Cardansan/Cruz-De-Seguridad/fotos/IMG_20190821_163145_097.jpg

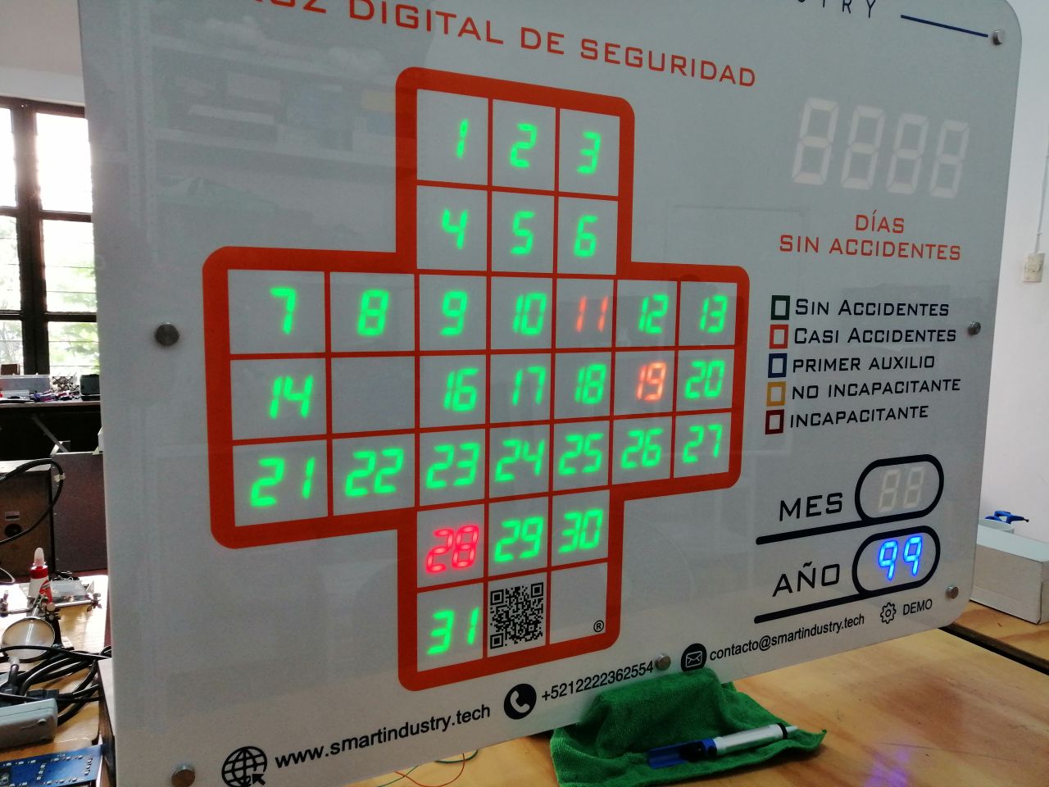
fotos/IMG_20190821_163145_097.jpg
