Cardansan/Cruz-De-Seguridad/fotos/IMG_20190821_163332_399.jpg

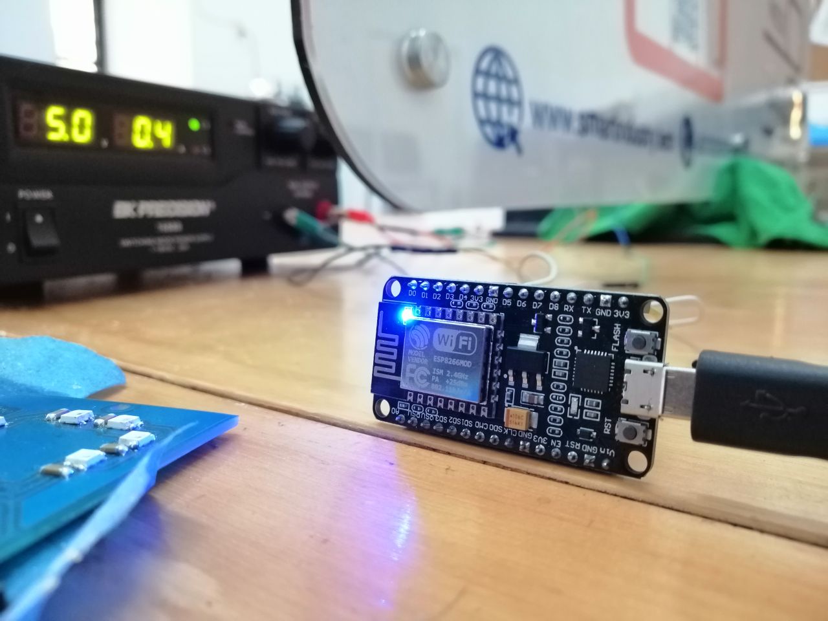
fotos/IMG_20190821_163332_399.jpg
