Cardansan/Cruz-De-Seguridad/README.md

# Cruz-De-Seguridad
Display Industria 4.0
