Cardansan/Cruz-De-Seguridad/diseños/Cortes 4 Dígitos Grande/Imágenes/4 Dígitos CABLE.JPG

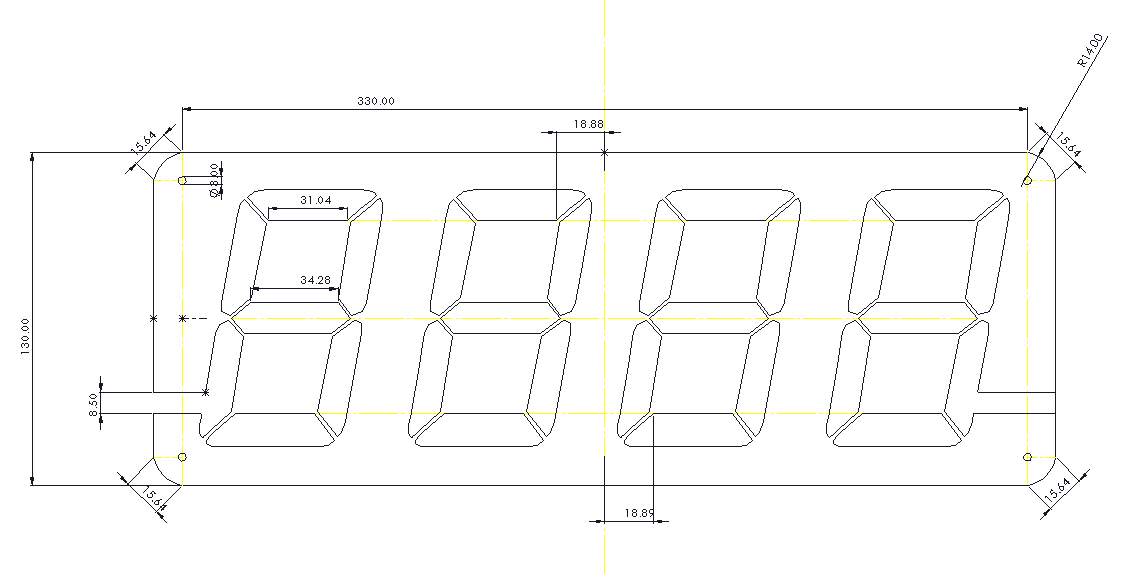
diseños/Cortes 4 Dígitos Grande/Imágenes/4 Dígitos CABLE.JPG
