Cardansan/Cruz-De-Seguridad/diseños/Cortes 4 Dígitos Grande/Imágenes/4 Dígitos TOP.JPG

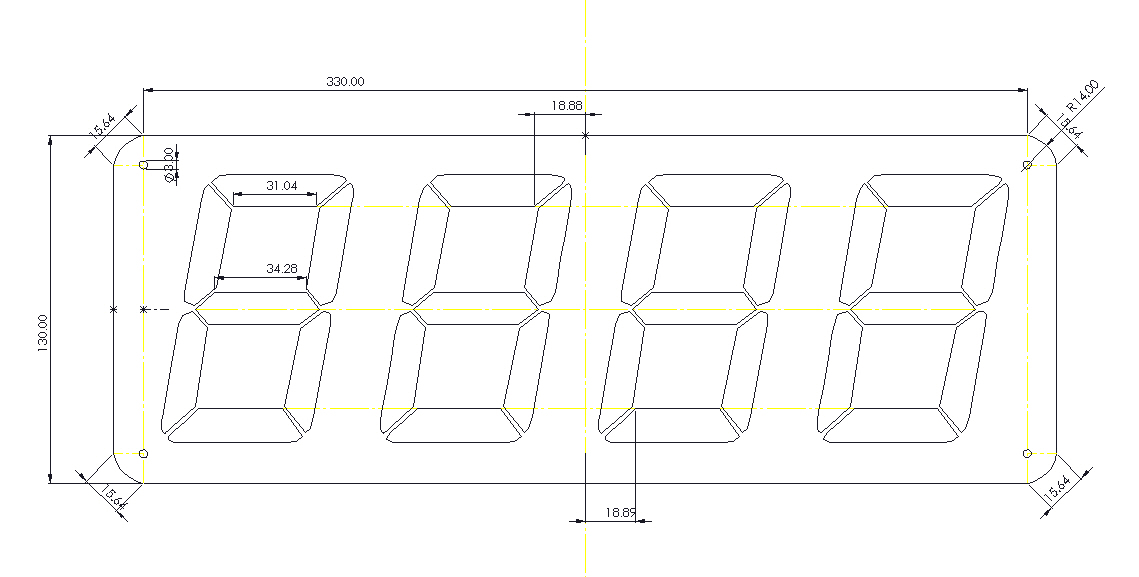
diseños/Cortes 4 Dígitos Grande/Imágenes/4 Dígitos TOP.JPG
