Cardansan/Cruz-De-Seguridad/diseños/PCB/Escudo_cruz/Conexion_SDCS.jpg

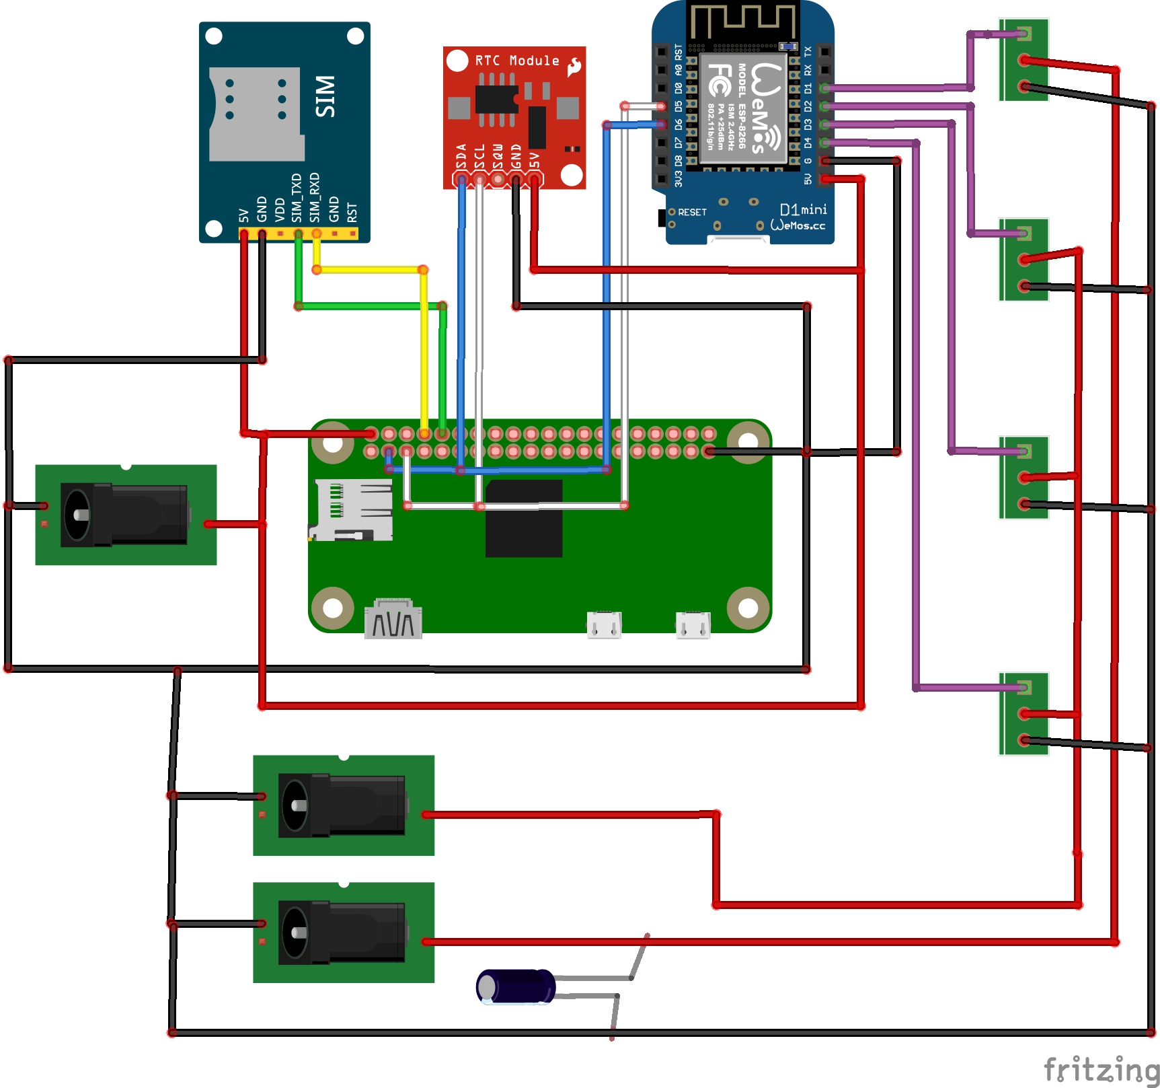
diseños/PCB/Escudo_cruz/Conexion_SDCS.jpg
