Cardansan/Cruz-De-Seguridad/fotos/IMG_20190808_111240.jpg

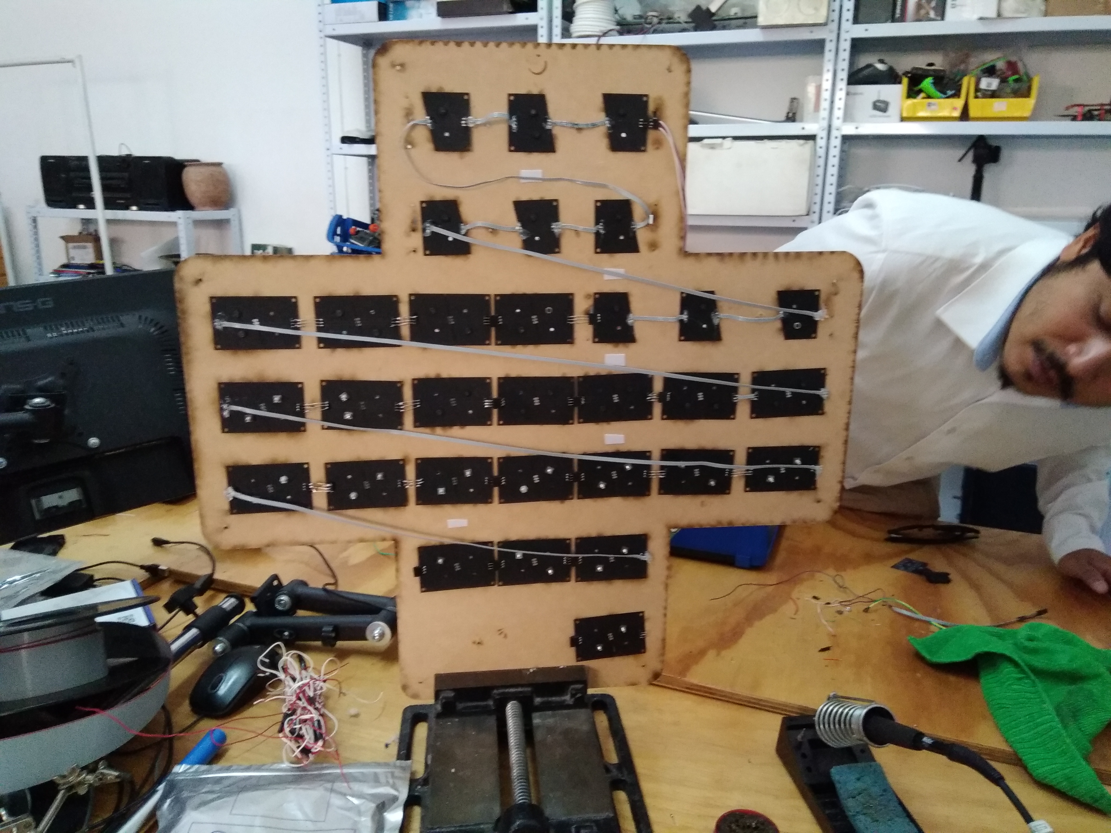
fotos/IMG_20190808_111240.jpg
