Cardansan/Cruz-De-Seguridad/fotos/IMG_20190814_174807.jpg

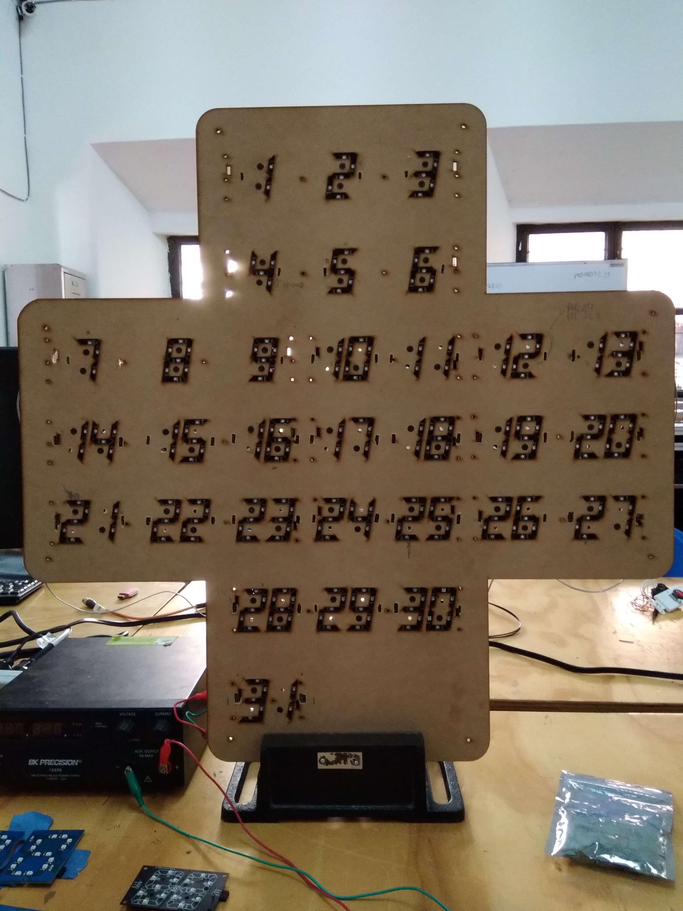
fotos/IMG_20190814_174807.jpg
