Cardansan/Cruz-De-Seguridad/fotos/IMG_20190814_174841.jpg

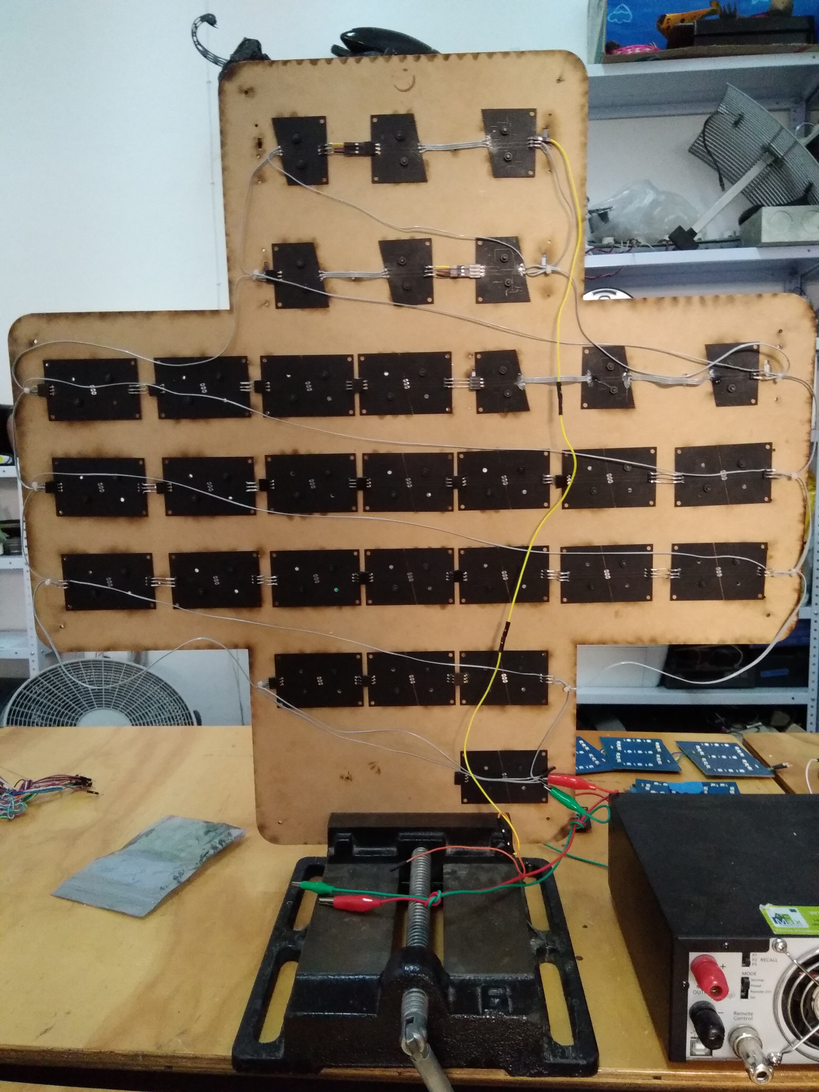
fotos/IMG_20190814_174841.jpg
