Cardansan/Cruz-De-Seguridad/fotos/IMG_20190816_145346.jpg

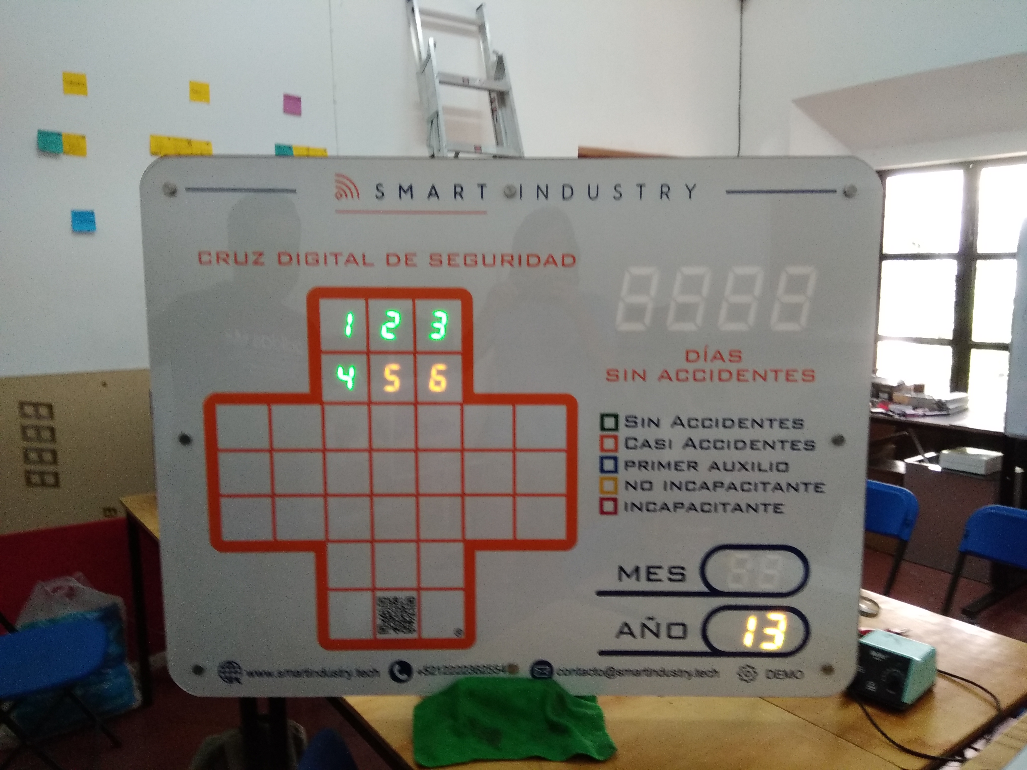
fotos/IMG_20190816_145346.jpg
