Cardansan/Cruz-De-Seguridad/fotos/IMG_20190816_145348.jpg

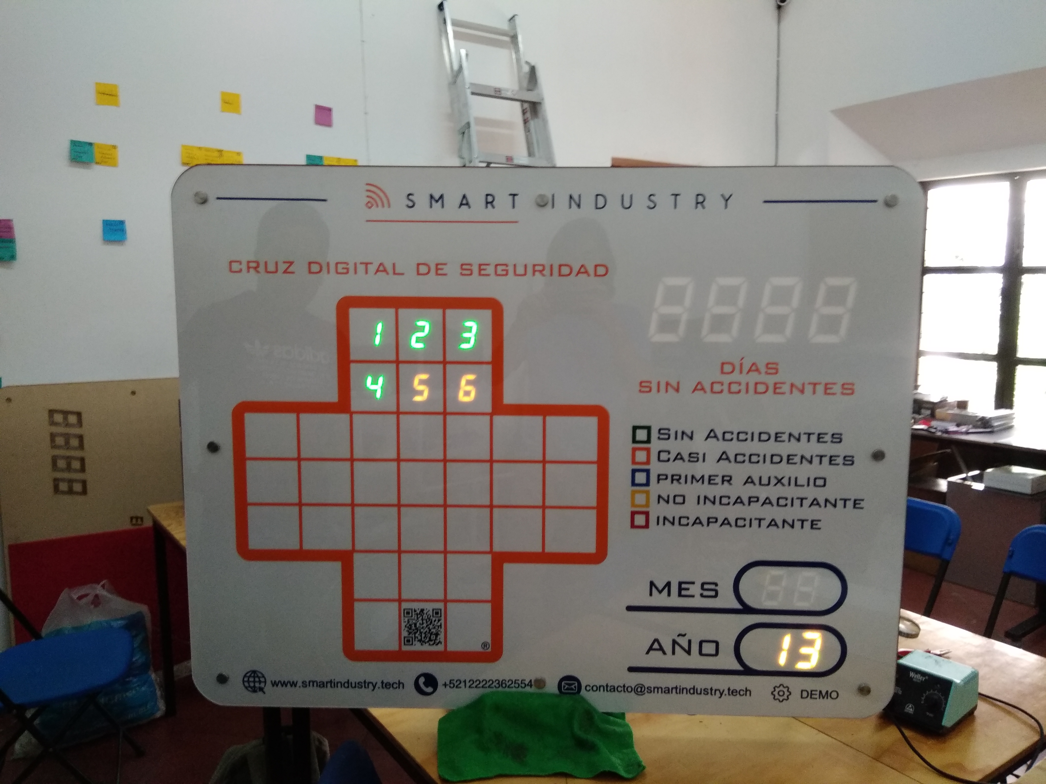
fotos/IMG_20190816_145348.jpg
