Cardansan/Cruz-De-Seguridad/fotos/IMG_20190816_145359.jpg

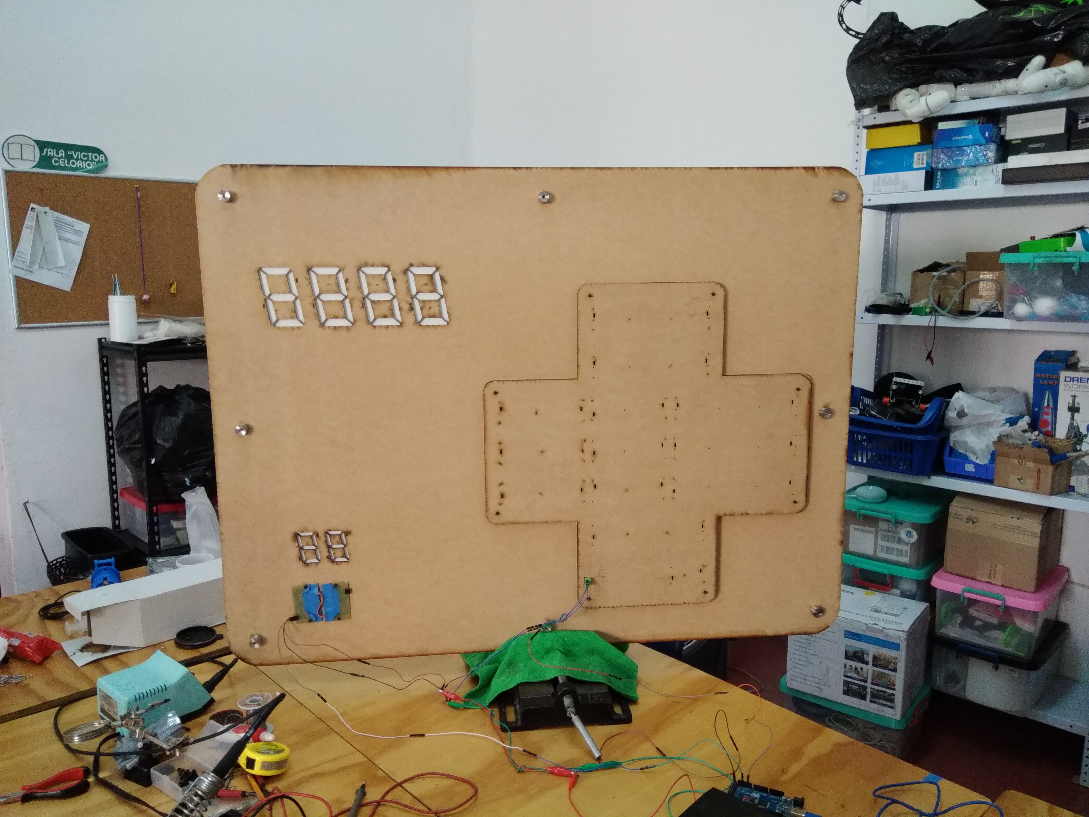
fotos/IMG_20190816_145359.jpg
