Cardansan/Cruz-De-Seguridad/fotos/IMG_20190821_163135_744.jpg

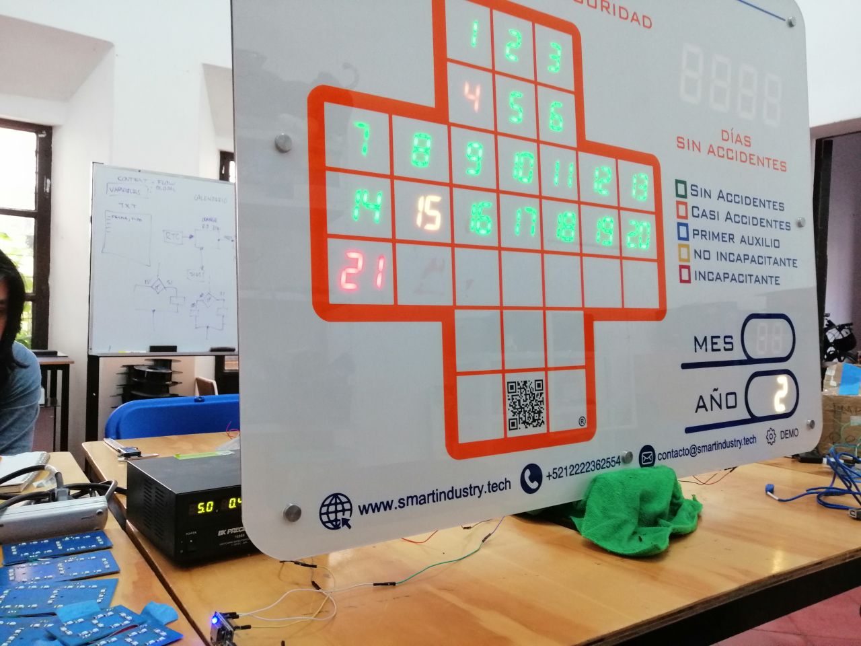
fotos/IMG_20190821_163135_744.jpg
