Cardansan/Cruz-De-Seguridad/fotos/IMG_20190821_163142_463.jpg

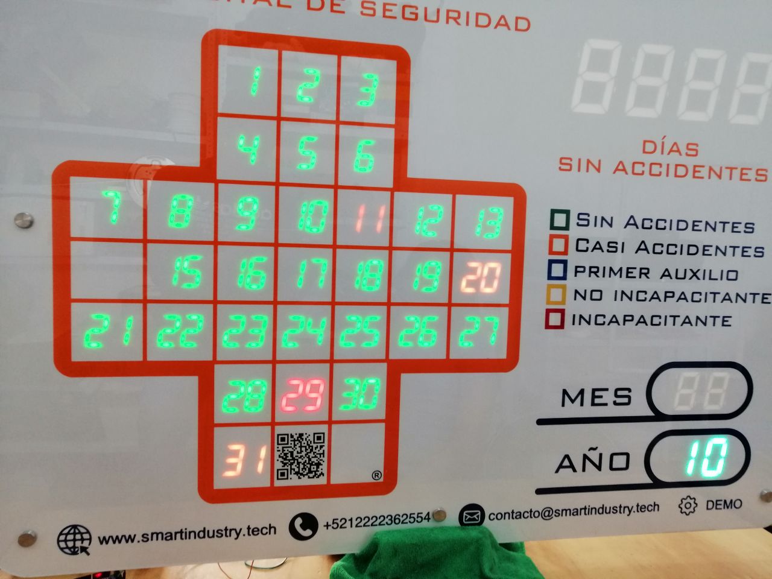
fotos/IMG_20190821_163142_463.jpg
