Cardansan/Cruz-De-Seguridad/diseños/Cortes 4 Dígitos Grande/Ensamble mdf unitario.SLDPRT

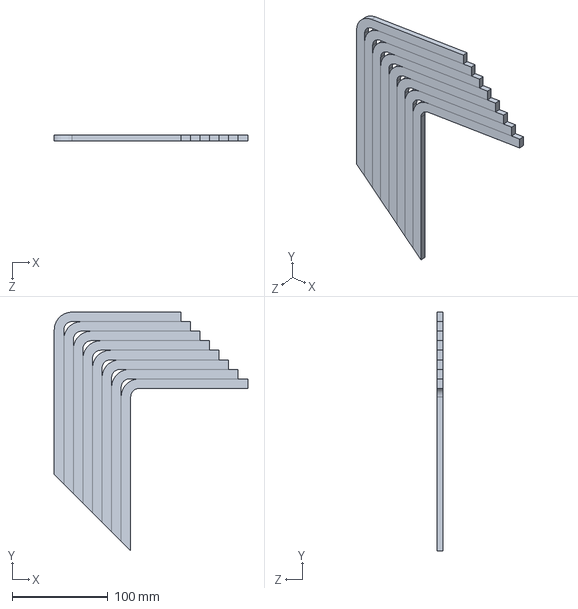
[picture p15: CAD file, 2019-05-18]
diseños/Cortes 4 Dígitos Grande/Ensamble mdf unitario.SLDPRT
202.5 x 250.0 x 6.00 mm
