Cardansan/Cruz-De-Seguridad/diseños/Ensamble/Ensamble cruz de seguridad.SLDASM

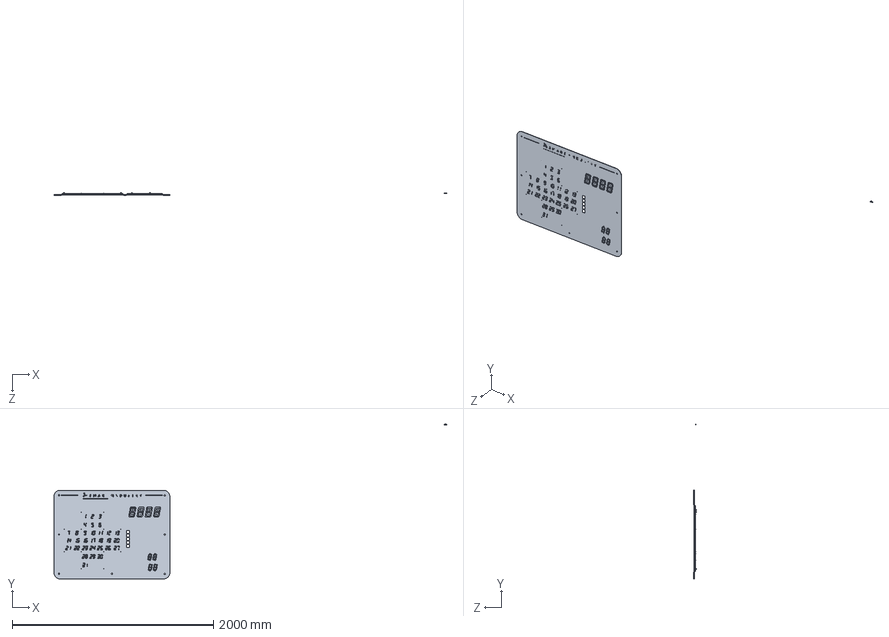
[picture p16: CAD file, 2019-06-06]
diseños/Ensamble/Ensamble cruz de seguridad.SLDASM
3904.5 x 1537.3 x 21.0 mm
Cruz Digital Original
Cruz capa 1
Cruz capa 2
Cruz capa 3
Pin_1 x 264
Pin_2 x 264
Pin_3 x 264
Pin_4 x 264
Pin_1_2 x 263
Pin_2_2 x 263
Layer_1
METRIC FLAT HEAD SLOTTED MACHINE SCREW M3x.5x20 x 16
Grupo 2 capa 1
Grupo 2 capa 3
Grupo 2 capa 2
Grupo 3 capa 1
Grupo 3 capa 2
Grupo 3 capa 3
