Cardansan/Cruz-De-Seguridad/(list of files, cad)

Other CAD files:
diseños/Ensamble/PCB MK XV/Open CASCADE STEP translator 6.8 1.202.sldasm
diseños/Ensamble/PCB MK XV/Open CASCADE STEP translator 6.8 1.4.1-160.sldasm
diseños/Ensamble/PCB MK XV/Open CASCADE STEP translator 6.8 1.508.sldasm
diseños/Ensamble/PCB MK XV/Open CASCADE STEP translator 6.8 1.4.1-197.sldasm
diseños/Ensamble/PCB MK XV/Open CASCADE STEP translator 6.8 1.2.1-217.sldasm
diseños/Ensamble/PCB MK XV/Open CASCADE STEP translator 6.8 1.2.1-164.sldasm
diseños/Ensamble/PCB MK XV/Open CASCADE STEP translator 6.8 1.140.sldasm
diseños/Ensamble/PCB MK XV/Open CASCADE STEP translator 6.8 1.4.1-29.sldasm
diseños/Ensamble/PCB MK XV/Open CASCADE STEP translator 6.8 1.4.1-256.sldasm
diseños/Ensamble/PCB MK XV/Open CASCADE STEP translator 6.8 1.2.1-130.sldasm
diseños/Ensamble/PCB MK XV/Open CASCADE STEP translator 6.8 1.2.1-125.sldasm
diseños/Ensamble/PCB MK XV/Open CASCADE STEP translator 6.8 1.194.sldasm
diseños/Ensamble/PCB MK XV/Open CASCADE STEP translator 6.8 1.539.sldasm
diseños/Ensamble/PCB MK XV/Open CASCADE STEP translator 6.8 1.466.1.sldasm
diseños/Ensamble/PCB MK XV/Open CASCADE STEP translator 6.8 1.2.1-28.sldasm
diseños/Ensamble/PCB MK XV/Open CASCADE STEP translator 6.8 1.4.1-118.sldasm
diseños/Ensamble/PCB MK XV/Open CASCADE STEP translator 6.8 1.26.sldasm
diseños/Ensamble/PCB MK XV/Open CASCADE STEP translator 6.8 1.4.1-26.sldasm
diseños/Ensamble/PCB MK XV/Open CASCADE STEP translator 6.8 1.410.sldasm
diseños/Ensamble/PCB MK XV/Open CASCADE STEP translator 6.8 1.227.sldasm
diseños/Ensamble/PCB MK XV/Open CASCADE STEP translator 6.8 1.95.1.sldasm
diseños/Ensamble/PCB MK XV/Open CASCADE STEP translator 6.8 1.2.1-65.sldasm
diseños/Ensamble/PCB MK XV/Open CASCADE STEP translator 6.8 1.47.sldasm
diseños/Ensamble/PCB MK XV/Open CASCADE STEP translator 6.8 1.2.1-234.sldasm
diseños/Ensamble/PCB MK XV/Open CASCADE STEP translator 6.8 1.2.1-192.sldasm
diseños/Ensamble/PCB MK XV/Open CASCADE STEP translator 6.8 1.2.1-22.sldasm
diseños/Ensamble/PCB MK XV/Open CASCADE STEP translator 6.8 1.311.sldasm
diseños/Ensamble/PCB MK XV/Open CASCADE STEP translator 6.8 1.2.1-150.sldasm
diseños/Ensamble/PCB MK XV/Open CASCADE STEP translator 6.8 1.97.sldasm
diseños/Ensamble/PCB MK XV/Open CASCADE STEP translator 6.8 1.136.sldasm
diseños/Ensamble/PCB MK XV/Open CASCADE STEP translator 6.8 1.89.sldasm
diseños/Ensamble/PCB MK XV/Open CASCADE STEP translator 6.8 1.173.sldasm
diseños/Ensamble/PCB MK XV/Open CASCADE STEP translator 6.8 1.278.sldasm
diseños/Ensamble/PCB MK XV/Open CASCADE STEP translator 6.8 1.4.1-255.sldasm
diseños/Ensamble/PCB MK XV/Open CASCADE STEP translator 6.8 1.555.1.sldasm
diseños/Ensamble/PCB MK XV/Open CASCADE STEP translator 6.8 1.2.1-41.sldasm
diseños/Ensamble/PCB MK XV/Open CASCADE STEP translator 6.8 1.4.1-210.sldasm
diseños/Ensamble/PCB MK XV/Open CASCADE STEP translator 6.8 1.176.sldasm
diseños/Ensamble/PCB MK XV/Open CASCADE STEP translator 6.8 1.4.1-117.sldasm
diseños/Ensamble/PCB MK XV/Open CASCADE STEP translator 6.8 1.416.sldasm
diseños/Ensamble/PCB MK XV/Open CASCADE STEP translator 6.8 1.4.1-70.sldasm
diseños/Ensamble/PCB MK XV/Open CASCADE STEP translator 6.8 1.556.sldasm
diseños/Ensamble/PCB MK XV/Open CASCADE STEP translator 6.8 1.4.1-65.sldasm
diseños/Ensamble/PCB MK XV/Open CASCADE STEP translator 6.8 1.4.1-109.sldasm
diseños/Ensamble/PCB MK XV/Open CASCADE STEP translator 6.8 1.4.1-151.sldasm
diseños/Ensamble/PCB MK XV/Open CASCADE STEP translator 6.8 1.413.sldasm
diseños/Ensamble/PCB MK XV/Open CASCADE STEP translator 6.8 1.4.1-124.sldasm
diseños/Ensamble/PCB MK XV/Open CASCADE STEP translator 6.8 1.4.1-177.sldasm
diseños/Ensamble/PCB MK XV/Open CASCADE STEP translator 6.8 1.139.1.sldasm
diseños/Ensamble/PCB MK XV/Open CASCADE STEP translator 6.8 1.235.sldasm
diseños/Ensamble/PCB MK XV/Open CASCADE STEP translator 6.8 1.4.1-139.sldasm
diseños/Ensamble/PCB MK XV/Open CASCADE STEP translator 6.8 1.121.sldasm
diseños/Ensamble/PCB MK XV/Open CASCADE STEP translator 6.8 1.30.sldasm
diseños/Ensamble/PCB MK XV/Open CASCADE STEP translator 6.8 1.472.sldasm
diseños/Ensamble/PCB MK XV/Open CASCADE STEP translator 6.8 1.455.sldasm
diseños/Ensamble/PCB MK XV/Open CASCADE STEP translator 6.8 1.4.1-83.sldasm
diseños/Ensamble/PCB MK XV/Open CASCADE STEP translator 6.8 1.4.1-120.sldasm
diseños/Ensamble/PCB MK XV/Open CASCADE STEP translator 6.8 1.4.1-119.sldasm
diseños/Ensamble/PCB MK XV/Open CASCADE STEP translator 6.8 1.498.sldasm
diseños/Ensamble/PCB MK XV/Open CASCADE STEP translator 6.8 1.339.sldasm
diseños/Ensamble/PCB MK XV/Open CASCADE STEP translator 6.8 1.4.1-77.sldasm
diseños/Ensamble/PCB MK XV/Open CASCADE STEP translator 6.8 1.555.sldasm
diseños/Ensamble/PCB MK XV/Open CASCADE STEP translator 6.8 1.2.1-120.sldasm
diseños/Ensamble/PCB MK XV/Open CASCADE STEP translator 6.8 1.4.1-66.sldasm
diseños/Ensamble/PCB MK XV/Open CASCADE STEP translator 6.8 1.130.sldasm
diseños/Ensamble/PCB MK XV/Open CASCADE STEP translator 6.8 1.2.1-95.sldasm
diseños/Ensamble/PCB MK XV/Open CASCADE STEP translator 6.8 1.4.1-108.sldasm
diseños/Ensamble/PCB MK XV/Open CASCADE STEP translator 6.8 1.118.sldasm
diseños/Ensamble/PCB MK XV/Open CASCADE STEP translator 6.8 1.4.1-183.sldasm
diseños/Ensamble/PCB MK XV/Open CASCADE STEP translator 6.8 1.507.1.sldasm
diseños/Ensamble/PCB MK XV/Open CASCADE STEP translator 6.8 1.4.1-57.sldasm
diseños/Ensamble/PCB MK XV/Open CASCADE STEP translator 6.8 1.2.1-160.sldasm
diseños/Ensamble/PCB MK XV/Open CASCADE STEP translator 6.8 1.383.sldasm
diseños/Ensamble/PCB MK XV/Open CASCADE STEP translator 6.8 1.533.sldasm
diseños/Ensamble/PCB MK XV/Open CASCADE STEP translator 6.8 1.556.1.sldasm
diseños/Ensamble/PCB MK XV/Open CASCADE STEP translator 6.8 1.221.sldasm
diseños/Ensamble/PCB MK XV/Open CASCADE STEP translator 6.8 1.4.1-149.sldasm
diseños/Ensamble/PCB MK XV/Open CASCADE STEP translator 6.8 1.59.sldasm
diseños/Ensamble/PCB MK XV/Open CASCADE STEP translator 6.8 1.549.sldasm
diseños/Ensamble/PCB MK XV/Open CASCADE STEP translator 6.8 1.4.1-194.sldasm
diseños/Ensamble/PCB MK XV/Open CASCADE STEP translator 6.8 1.307.sldasm
diseños/Ensamble/PCB MK XV/Open CASCADE STEP translator 6.8 1.2.1-238.sldasm
diseños/Ensamble/PCB MK XV/Open CASCADE STEP translator 6.8 1.2.1-107.sldasm
diseños/Ensamble/PCB MK XV/Open CASCADE STEP translator 6.8 1.2.1-155.sldasm
diseños/Ensamble/PCB MK XV/Open CASCADE STEP translator 6.8 1.49.sldasm
diseños/Ensamble/PCB MK XV/Open CASCADE STEP translator 6.8 1.448.sldasm
diseños/Ensamble/PCB MK XV/Open CASCADE STEP translator 6.8 1.387.sldasm
diseños/Ensamble/PCB MK XV/Open CASCADE STEP translator 6.8 1.95.sldasm
diseños/Ensamble/PCB MK XV/Open CASCADE STEP translator 6.8 1.15.sldasm
diseños/Ensamble/PCB MK XV/Open CASCADE STEP translator 6.8 1.230.sldasm
diseños/Ensamble/PCB MK XV/Open CASCADE STEP translator 6.8 1.302.sldasm
diseños/Ensamble/PCB MK XV/Open CASCADE STEP translator 6.8 1.4.1-258.sldasm
diseños/Ensamble/PCB MK XV/Open CASCADE STEP translator 6.8 1.2.1-146.sldasm
diseños/Ensamble/PCB MK XV/Open CASCADE STEP translator 6.8 1.2.1-94.sldasm
diseños/Ensamble/PCB MK XV/Open CASCADE STEP translator 6.8 1.275.sldasm
diseños/Ensamble/PCB MK XV/Open CASCADE STEP translator 6.8 1.210.sldasm
diseños/Ensamble/PCB MK XV/Open CASCADE STEP translator 6.8 1.2.1-31.sldasm
diseños/Ensamble/PCB MK XV/Open CASCADE STEP translator 6.8 1.512.sldasm
diseños/Ensamble/PCB MK XV/Open CASCADE STEP translator 6.8 1.27.sldasm
diseños/Ensamble/PCB MK XV/Open CASCADE STEP translator 6.8 1.4.1-226.sldasm
diseños/Ensamble/PCB MK XV/Open CASCADE STEP translator 6.8 1.4.1-158.sldasm
diseños/Ensamble/PCB MK XV/Open CASCADE STEP translator 6.8 1.4.1-89.sldasm
diseños/Ensamble/PCB MK XV/Open CASCADE STEP translator 6.8 1.319.sldasm
diseños/Ensamble/PCB MK XV/Open CASCADE STEP translator 6.8 1.120.sldasm
diseños/Ensamble/PCB MK XV/Open CASCADE STEP translator 6.8 1.2.1-194.sldasm
diseños/Ensamble/PCB MK XV/Open CASCADE STEP translator 6.8 1.4.1-138.sldasm
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
