Cardansan/Cruz-De-Seguridad/diseños/Ensamble/Diagrama_conexiones.jpg

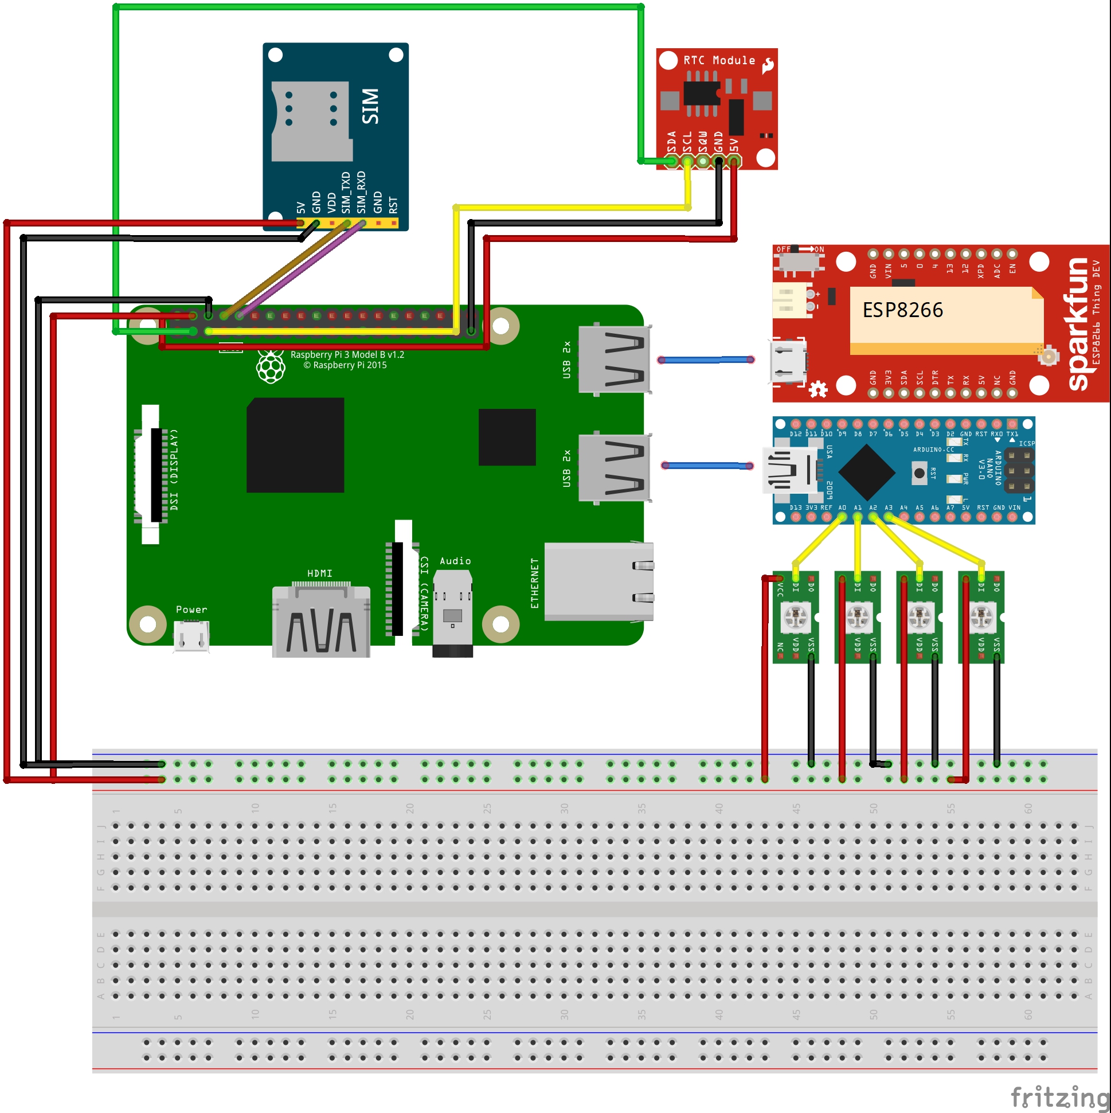
diseños/Ensamble/Diagrama_conexiones.jpg
