Cardansan/Cruz-De-Seguridad/diseños/Ensamble/ESP8266.jpg

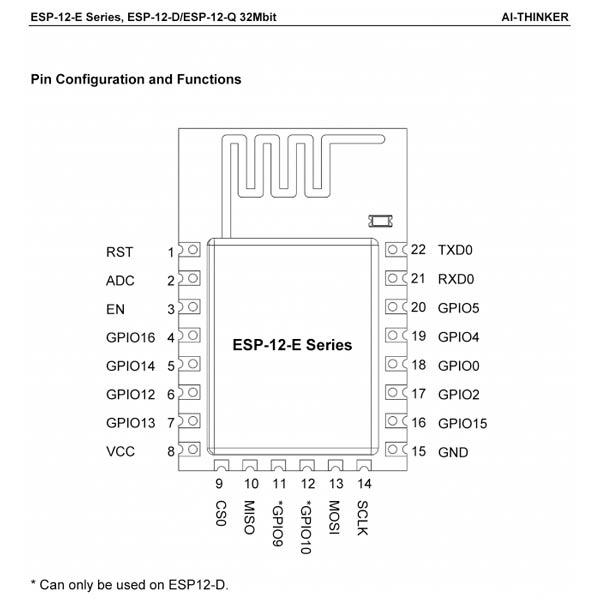
diseños/Ensamble/ESP8266.jpg
