Cardansan/Cruz-De-Seguridad/(list of files, drawings)

Other design files:
diseños/Ensamble/PCB MK XV/pcb segmentos digitos correctos.pdsprj
diseños/Ensamble/PCB MK XV/pcb segmentos digitos MK I.pdsprj
diseños/Ensamble/PCB MK XV/pcb segmentos_digitos.pdsprj
diseños/PCB/1-3.pdsprj
diseños/PCB/4-6.pdsprj
diseños/PCB/7-9.pdsprj
diseños/PCB/10-11.pdsprj
diseños/PCB/12-13.pdsprj
diseños/PCB/14-16.pdsprj
diseños/PCB/17-18.pdsprj
diseños/PCB/19-20.pdsprj
diseños/PCB/21-23.pdsprj
diseños/PCB/24-25.pdsprj
diseños/PCB/26-27.pdsprj
diseños/PCB/28-30.pdsprj
diseños/PCB/31.pdsprj
