Cardansan/Cruz-De-Seguridad/diseños/PCB/P2345.brd

## EAGLE design diseños/PCB/P2345.brd (2019-10-04)

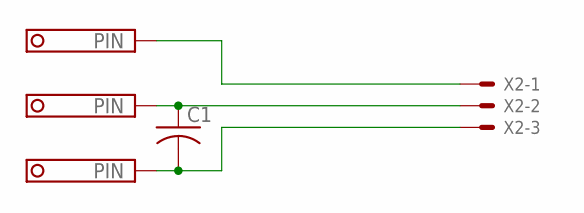
[picture p19: schematic P2345.sch]

Parts:
C1: C-US050-024X044; C050-024X044
X1: TERMINAL-BLOCK-3.5MM-3-PIN-ROUND-PAD; TERMINAL-BLOCK-3-PIN-3.5MM-ROUND-PAD
X2: JST-XH-03-PIN-ROUND-PAD; JST-XH-03-PACKAGE-ROUND-PAD

Connections:
unnamed: X1.1, X2.1
unnamed: C1.1, X1.2, X2.2
unnamed: C1.2, X1.3, X2.3

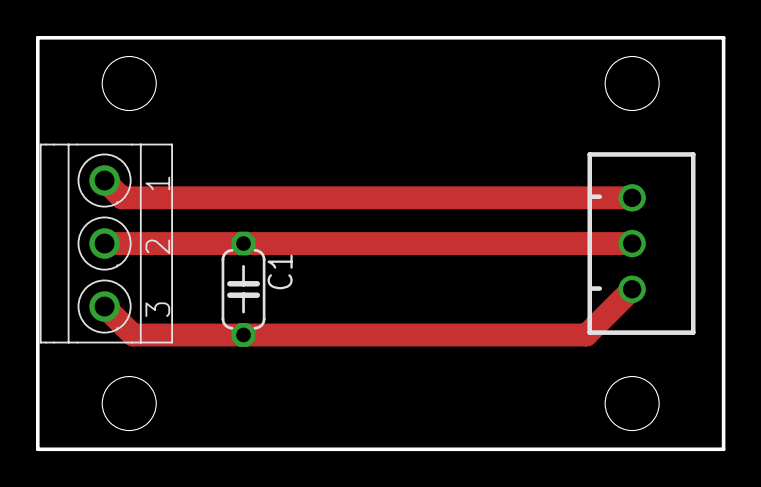
[picture p20: board P2345.brd from above]

Board: 2 copper layers, 38.1 x 22.9 mm, 3 parts (0 on the bottom side), 3 nets.
