Cardansan/Cruz-De-Seguridad/diseños/PCB/P1.brd

## EAGLE design diseños/PCB/P1.brd (2019-10-04)

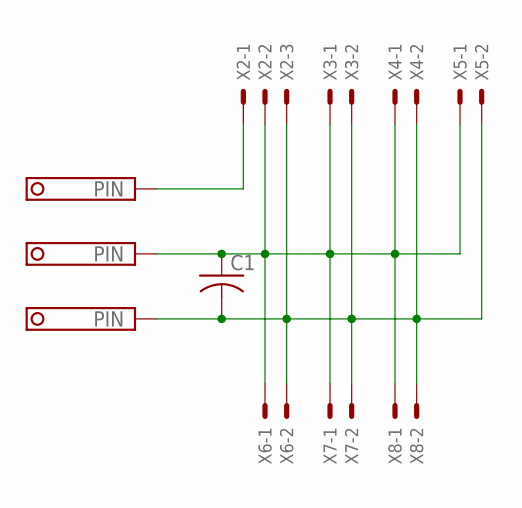
[picture p21: schematic P1.sch]

Parts:
C1: C-US050-024X044; C050-024X044
X1: TERMINAL-BLOCK-3.5MM-3-PIN-ROUND-PAD; TERMINAL-BLOCK-3-PIN-3.5MM-ROUND-PAD
X2: JST-XH-03-PIN-ROUND-PAD; JST-XH-03-PACKAGE-ROUND-PAD
X3, X4, X5, X6, X7, X8: JST-XH-02-PIN-ROUND-PAD; JST-XH-02-PACKAGE-ROUND-PAD

Connections:
unnamed: X1.1, X2.1
unnamed: C1.2, X1.3, X2.3, X3.2, X4.2, X5.2, X6.2, X7.2, X8.2
unnamed: C1.1, X1.2, X2.2, X3.1, X4.1, X5.1, X6.1, X7.1, X8.1

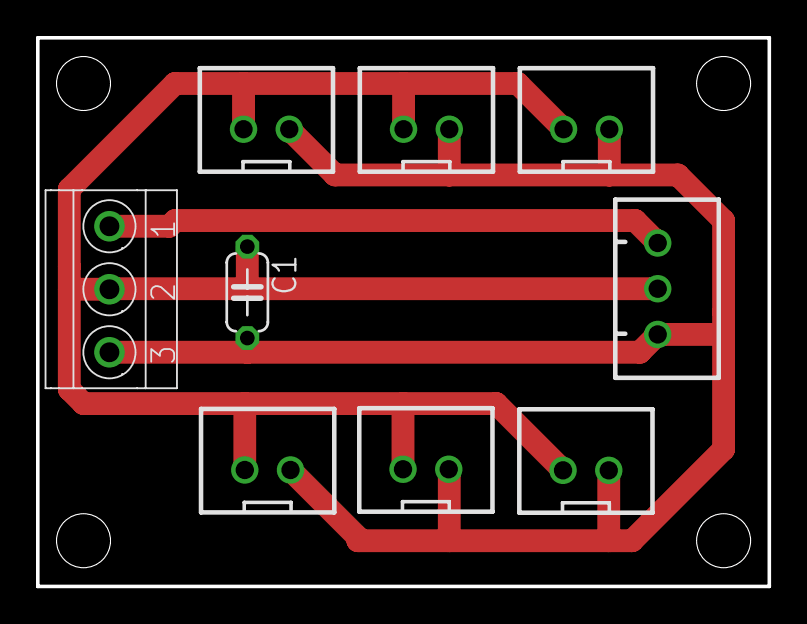
[picture p22: board P1.brd from above]

Board: 2 copper layers, 40.6 x 30.5 mm, 9 parts (0 on the bottom side), 3 nets.
