Cardansan/Cruz-De-Seguridad/diseños/PCB/Escudo_cruz/Escudo_cruz.brd

## EAGLE design diseños/PCB/Escudo_cruz/Escudo_cruz.brd (2019-09-11)

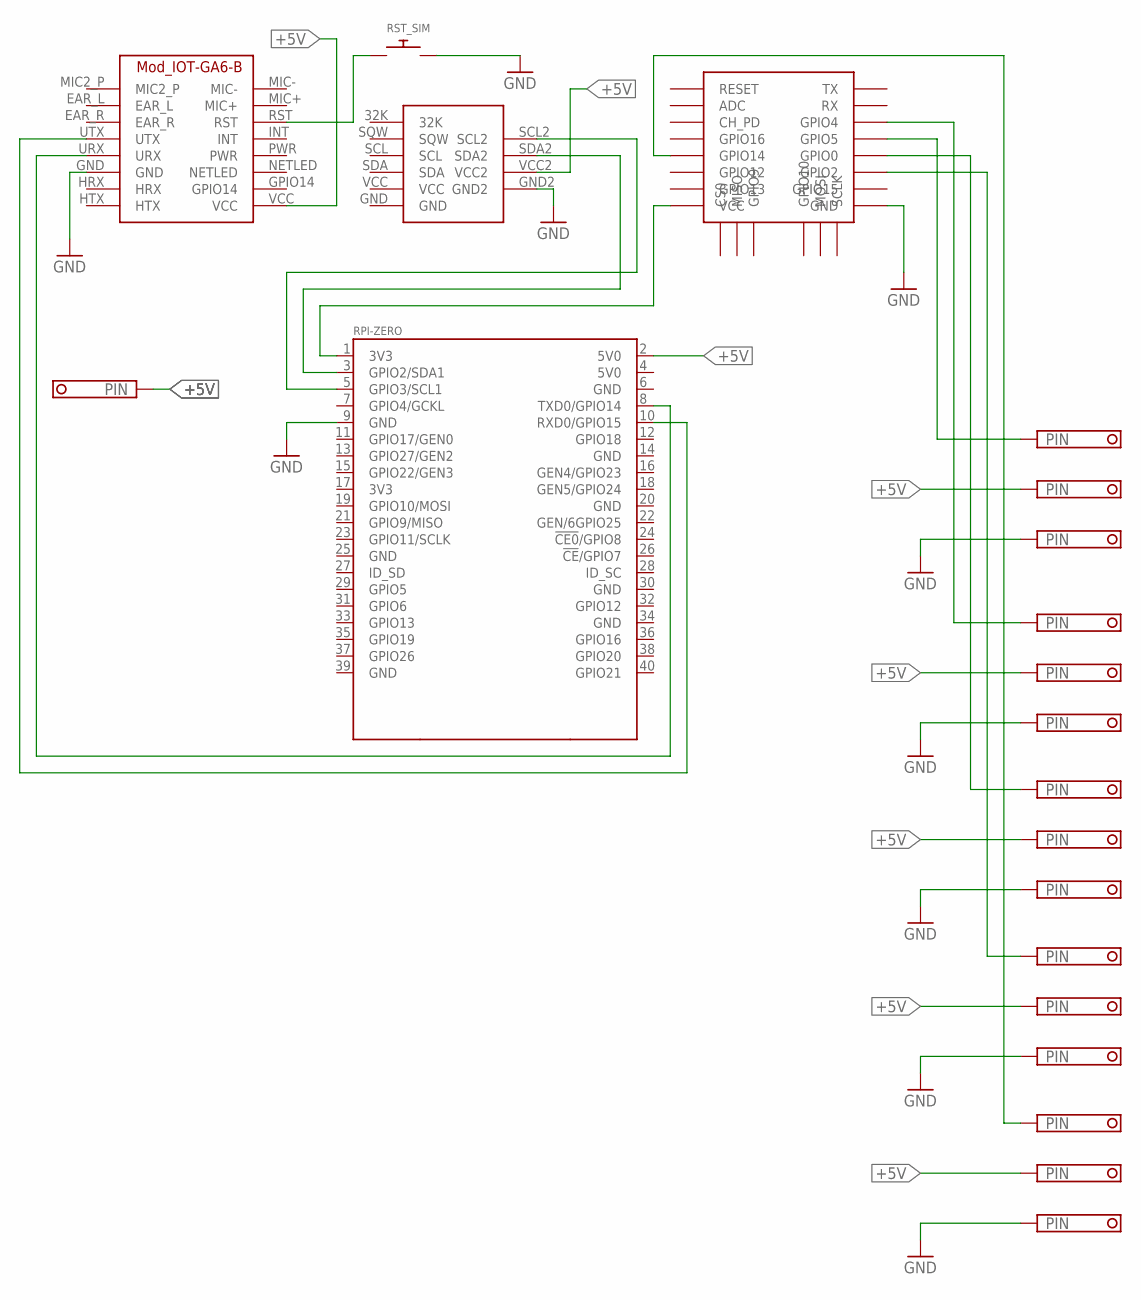
[picture p23: schematic Escudo_cruz.sch]

Parts:
AÑO: TERMINAL-BLOCK-3.5MM-3-PIN-ROUND-PAD; TERMINAL-BLOCK-3-PIN-3.5MM-ROUND-PAD
CRUZ: TERMINAL-BLOCK-3.5MM-3-PIN-ROUND-PAD; TERMINAL-BLOCK-3-PIN-3.5MM-ROUND-PAD
DÍAZ: TERMINAL-BLOCK-3.5MM-3-PIN-ROUND-PAD; TERMINAL-BLOCK-3-PIN-3.5MM-ROUND-PAD
ESP8266: ESP12Q
INDICADOR: TERMINAL-BLOCK-3.5MM-3-PIN-ROUND-PAD; TERMINAL-BLOCK-3-PIN-3.5MM-ROUND-PAD
MES: TERMINAL-BLOCK-3.5MM-3-PIN-ROUND-PAD; TERMINAL-BLOCK-3-PIN-3.5MM-ROUND-PAD
POWER: TERMINAL-BLOCK-3.5MM-2-PIN-ROUND-PAD; TERMINAL-BLOCK-2-PIN-3.5MM-ROUND-PAD
RST_SIM: SWITCH_PUSHBUTTONSOFTTOUCHSMD_SJ; PUSHBUTTON_SMD_SJ
SIM: IOT-GA6-B
U$2: RPI-ZERO; RASPBERRYPI_BASTELSTUBE_V13_RASPI_BOARD_B+_FULL
U$4: RTC_DS3231

Connections:
3V3@1: ESP8266.VCC, U$2.1 (3V3)
+5V: AÑO.2, CRUZ.2, DÍAZ.2, MES.2, POWER.1, SIM.VCC, U$2.2 (5V0)
GND: AÑO.3, CRUZ.3, DÍAZ.3, ESP8266.GND, INDICADOR.3, MES.3, RST_SIM.P$2, SIM.GND, U$4.GND2
GND@1: U$2.9 (GND)
unnamed: SIM.URX, U$2.8 (TXD0/GPIO14)
unnamed: SIM.UTX, U$2.10 (RXD0/GPIO15)
unnamed: U$2.3 (GPIO2/SDA1), U$4.SDA2
unnamed: U$2.5 (GPIO3/SCL1), U$4.SCL2
unnamed: RST_SIM.P$1, SIM.RST
unnamed: CRUZ.1, ESP8266.GPIO5
unnamed: ESP8266.GPIO14, INDICADOR.1
unnamed: DÍAZ.1, ESP8266.GPIO4
unnamed: ESP8266.GPIO0, MES.1
unnamed: AÑO.1, ESP8266.GPIO2

Board: 2 copper layers, 11 parts (1 on the bottom side), 13 nets, no tracks yet.
