Cardansan/Cruz-De-Seguridad/diseños/PCB/Displays/PRY417 Med.brd

## EAGLE design diseños/PCB/Displays/PRY417 Med.brd (2019-09-04)

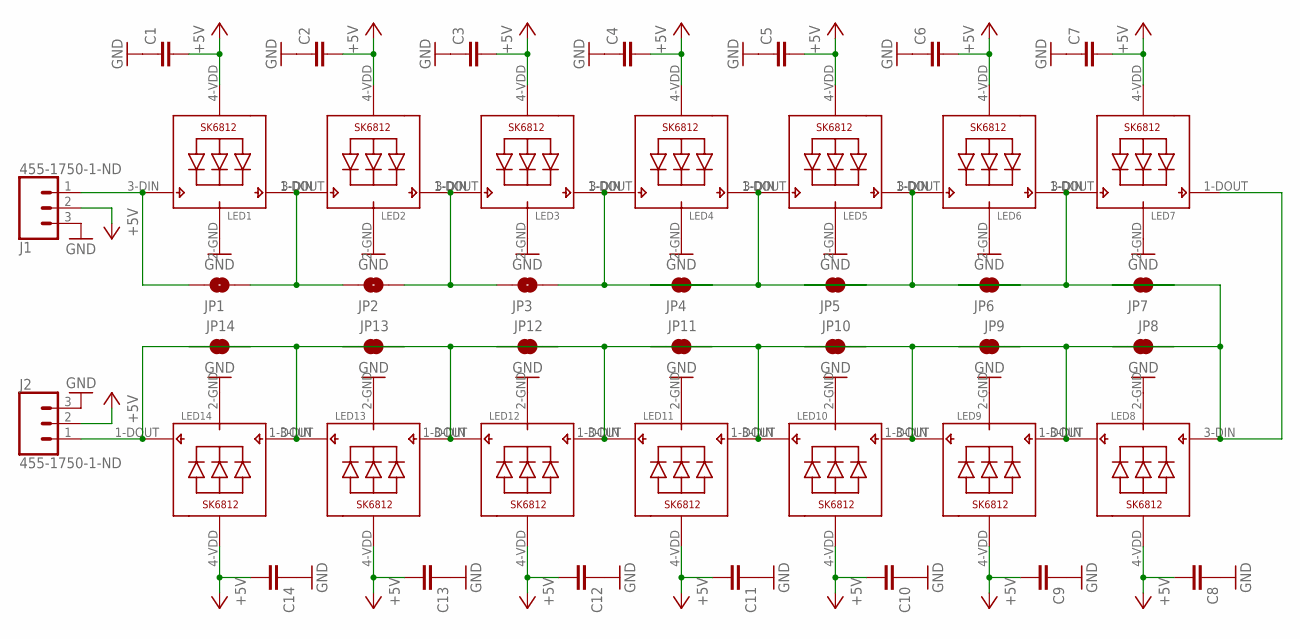
[picture p24: schematic PRY417 Med.sch]

Parts:
C1, C2, C3, C4, C5, C6, C7, C8, C9, C10, C11, C12, C13, C14: C-EUC1206; C1206
J1, J2: 455-1750-1-ND; 1X03
JP1, JP2, JP3, JP4, JP5, JP6, JP7, JP8, JP9, JP10, JP11, JP12, JP13, JP14: JUMPER-SMT_2_NO_SILK; SMT-JUMPER_2_NO_SILK
LED1, LED2, LED3, LED4, LED5, LED6, LED7, LED8, LED9, LED10, LED11, LED12, LED13, LED14: SK6812_3535; LED3535

Connections:
+5V: C1.2, C2.2, C3.2, C4.2, C5.2, C6.2, C7.2, C8.2, C9.2, C10.2, C11.2, C12.2, C13.2, C14.2, J1.2, J2.2, LED1.4-VDD (VDD), LED2.4-VDD (VDD), LED3.4-VDD (VDD), LED4.4-VDD (VDD), LED5.4-VDD (VDD), LED6.4-VDD (VDD), LED7.4-VDD (VDD), LED8.4-VDD (VDD), LED9.4-VDD (VDD), LED10.4-VDD (VDD), LED11.4-VDD (VDD), LED12.4-VDD (VDD), LED13.4-VDD (VDD), LED14.4-VDD (VDD)
GND: C1.1, C2.1, C3.1, C4.1, C5.1, C6.1, C7.1, C8.1, C9.1, C10.1, C11.1, C12.1, C13.1, C14.1, J1.3, J2.3, LED1.2-GND (GND), LED2.2-GND (GND), LED3.2-GND (GND), LED4.2-GND (GND), LED5.2-GND (GND), LED6.2-GND (GND), LED7.2-GND (GND), LED8.2-GND (GND), LED9.2-GND (GND), LED10.2-GND (GND), LED11.2-GND (GND), LED12.2-GND (GND), LED13.2-GND (GND), LED14.2-GND (GND)
unnamed: JP1.2, JP2.1, LED1.1-DOUT (DO), LED2.3-DIN (DI)
unnamed: JP2.2, JP3.1, LED2.1-DOUT (DO), LED3.3-DIN (DI)
unnamed: JP3.2, JP4.2, LED3.1-DOUT (DO), LED4.3-DIN (DI)
unnamed: JP4.1, JP5.2, LED4.1-DOUT (DO), LED5.3-DIN (DI)
unnamed: JP5.1, JP6.2, LED5.1-DOUT (DO), LED6.3-DIN (DI)
unnamed: JP6.1, JP7.2, LED6.1-DOUT (DO), LED7.3-DIN (DI)
unnamed: JP8.1, JP9.2, LED8.1-DOUT (DO), LED9.3-DIN (DI)
unnamed: JP9.1, JP10.2, LED9.1-DOUT (DO), LED10.3-DIN (DI)
unnamed: JP10.1, JP11.2, LED10.1-DOUT (DO), LED11.3-DIN (DI)
unnamed: JP11.1, JP12.2, LED11.1-DOUT (DO), LED12.3-DIN (DI)
unnamed: JP12.1, JP13.2, LED12.1-DOUT (DO), LED13.3-DIN (DI)
unnamed: JP13.1, JP14.2, LED13.1-DOUT (DO), LED14.3-DIN (DI)
unnamed: JP7.1, JP8.2, LED7.1-DOUT (DO), LED8.3-DIN (DI)
unnamed: J1.1, JP1.1, LED1.3-DIN (DI)
unnamed: J2.1, JP14.1, LED14.1-DOUT (DO)

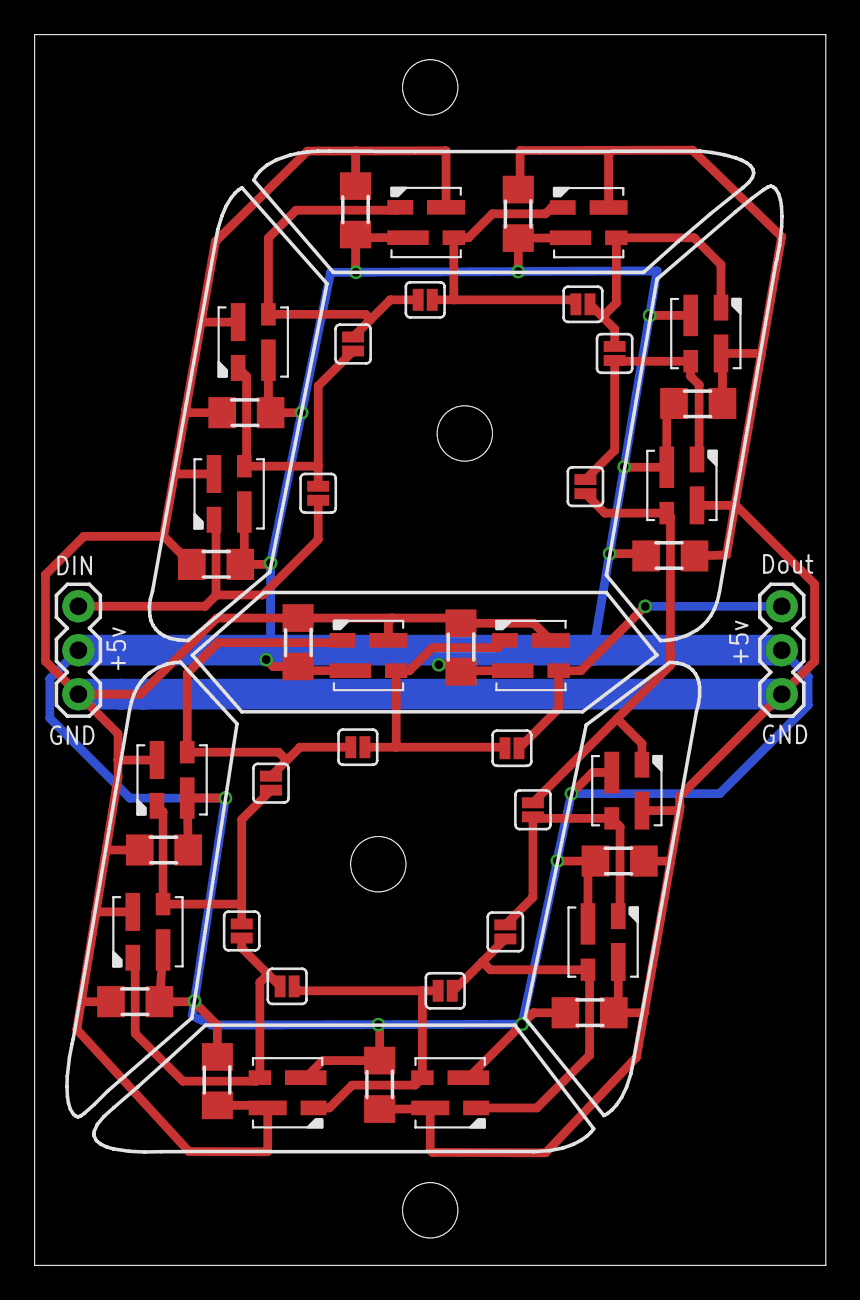
[picture p25: board PRY417 Med.brd from above]

Board: 2 copper layers, 45.7 x 71.1 mm, 44 parts (0 on the bottom side), 17 nets.
