Cardansan/Cruz-De-Seguridad/src/Display_Cruz_de_Seguridad.ino

//Programa para la Cruz de Seguridad
//NOMENCLATURA: A lo largo de este programa se usan variables como mes o día, cada una referente
//a secciones diferentes del display. La relación es la siguiente:
//"días" - Se referirá al display de 4 dígitos que tiene 3 npx por segmento
//"fecha" - Se referirá a los 229 neopixels que conforman las 31 posibles fechas del Mes
//"mes" - Trata de los dos dígitos con dos neopixels por segmento del inferior del display, arriba del año
//"año" - Trata de los dos dígitos con dos neopixels por segmento del inferior del display, debajo del mes


//#include <Wire.h>
//#include <SPI.h>
#include "Arduino.h"
#include <Adafruit_NeoPixel.h>
#include <ESP8266WiFi.h>
#include <ESP8266WebServer.h>
#include <WebSocketsServer.h>
#include <ESP8266mDNS.h>
#include <FS.h>
//#include <Wire.h>
#include <ESP8266HTTPUpdateServer.h>

#define PIN D1      // cruz
#define PIN1 D2     // dias totales
#define PIN2 D3     // mes
#define PIN3 D4     // año
#define Brightness 255
//#define NUM_PIXELS 369
#define NUM_PIXELS 229  //cruz
#define NUM_PIXELS1 84  //dias totales
<<<<<<< Updated upstream
#define NUM_PIXELS2 14 //Mes
#define NUM_PIXELS3 14 //año

Adafruit_NeoPixel strip = Adafruit_NeoPixel(NUM_PIXELS, PIN, NEO_GRB + NEO_KHZ800);       //Cruz
Adafruit_NeoPixel strip1 = Adafruit_NeoPixel(NUM_PIXELS1, PIN1, NEO_GRBW + NEO_KHZ800);    //Dias
Adafruit_NeoPixel strip2 = Adafruit_NeoPixel(NUM_PIXELS2, PIN2, NEO_GRBW + NEO_KHZ800);    // Mes
Adafruit_NeoPixel strip3 = Adafruit_NeoPixel(NUM_PIXELS3, PIN3, NEO_GRBW + NEO_KHZ800);    // Año
=======
#define NUM_PIXELS2 14 //Mes un LED por segmento
#define NUM_PIXELS3 14 //año un LED por segmento

Adafruit_NeoPixel strip = Adafruit_NeoPixel(NUM_PIXELS, PIN, NEO_GRB + NEO_KHZ400);
Adafruit_NeoPixel strip1 = Adafruit_NeoPixel(NUM_PIXELS1, PIN1, NEO_WGRB + NEO_KHZ400);
Adafruit_NeoPixel strip2 = Adafruit_NeoPixel(NUM_PIXELS2, PIN2, NEO_GRB + NEO_KHZ400);
Adafruit_NeoPixel strip3 = Adafruit_NeoPixel(NUM_PIXELS3, PIN3, NEO_GRB + NEO_KHZ400);
>>>>>>> Stashed changes

const int numPixAnio = 14;
const int numPixMes = 14;
const int numPixDias = 84;
const int numPixFechas = 229;

ESP8266WebServer server(80);
WebSocketsServer webSocket = WebSocketsServer(81);
ESP8266HTTPUpdateServer httpUpdater;
File fsUploadFile;

const char WiFiAPPSK[] = "d1spl4y4.0";  //CONTRASEÑA
const char ssid[] = "Cruz_de_Seguridad"; // NOMBRE DE LA RED

int serialCont=0;
int fechaAccidente;


// La inicializacion de estas variables se debería guardar en memoria no volatil
String dia = "0";
String valFecha = "0001";
String valColor = "0127";
String valDiaActual = "0001";
String valMes = "00";
String valAnio = "00";
int nfecha, color, color1, ndiaact, tecla, mes, anio;
int newmostrar, newOmitir;

byte numbers[] = {
  B11101110,    // 0
  B10001000,    // 1
  B01111100,    // 2    5555
  B11011100,    // 3   6    4
  B10011010,    // 4    3333
  B11010110,    // 5   2    0
  B11110110,    // 6    1111
  B10001100,    // 7
  B11111110,    // 8
  B10011110    // 9
};

byte numbersINV[] = {
  B11101110,    // 0
  B10001000,    // 1
  B11010110,    // 2    5555
  B11011100,    // 3   4    6
  B10111000,    // 4    3333
  B01111100,    // 5   0    2
  B01111110,    // 6    1111
  B11001000,    // 7
  B11111110,    // 8
  B11111000    // 9
};
//Cuántos segmentos ocupa cada número de día del mes
int segmDia[]{0,2,5,5,4,5,6,3,7,6,8,4,7,7,6,7,8,5,9,8,11,7,10,10,9,10,11,8,12,11,11,7};
//Suma total de segmentos iluminados hasta el día actual
int segmDiaTotal[]{0,2,7,12,16,21,27,30,37,43,51,55,62,69,75,82,90,95,104,112,123,130,140,150,159,169,180,188,200,211,222,229};
//int newsegmDia[]{0,0,0,0,0,0,0,0,0,0,0,0,0,0,0,0,0,0,0,0,0,0,0,0,0,0,0,0,0,0,0,0};

//Socket.send('Connect ' + new Date());
//char webpage[] PROGMEM = R"=====()=====";
// ----------------------------------------------------------------- handleFileUpload
//funcion para actualizar archivos OTA
void handleFileUpload()
{
  HTTPUpload& upload = server.upload();
  if(upload.status == UPLOAD_FILE_START)
  {
    String filename = upload.filename;
    if(!filename.startsWith("/"))
      filename = "/"+filename;
    Serial.print("handleFileUpload Name: "); Serial.println(filename);
    fsUploadFile = SPIFFS.open(filename, "w");
  } else if(upload.status == UPLOAD_FILE_WRITE)
  {
    if(fsUploadFile)
      fsUploadFile.write(upload.buf, upload.currentSize);
  } else if(upload.status == UPLOAD_FILE_END)
  {
    if(fsUploadFile)
      fsUploadFile.close();
    Serial.print("handleFileUpload Size: "); Serial.println(upload.totalSize);
  }
}

//----------------------------------------------------------------handleFileList
void handleFileList()
{
  String path = "/";
  // Assuming there are no subdirectories
  Dir dir = SPIFFS.openDir(path);
  String output = "[";
  while(dir.next())
  {
    File entry = dir.openFile("r");
    // Separate by comma if there are multiple files
    if(output != "[")
      output += ",";
    output += String(entry.name()).substring(1);
    entry.close();
  }
  output += "]";
  server.send(200, "text/plain", output);
}

// --------------------------------------------------------------------------- handleIndexFile
void handleIndexFile()
{
  File file = SPIFFS.open("/index.html","r");
  server.streamFile(file, "text/html");
  file.close();
}


//------------------------------------------------------------------------------ setupWiFi
void setupWiFi()
{
  WiFi.mode(WIFI_AP);   // Recordar que el procesador puede generar ambas funciones al mismo tiempo
  WiFi.softAP(ssid, WiFiAPPSK);
  Serial.print("\n &IP Address: ");
  Serial.println(WiFi.softAPIP()); //WiFi.localIP()
}

//-------------------------------------------------------------------------------webSocketEvent
void webSocketEvent(uint8_t num, WStype_t type, uint8_t * payload, size_t length)
{
  switch(type)
    {
      case WStype_TEXT:
        for(int i = 0; i < length; i++) Serial.print((char) payload[i]);
        Serial.println("");
      break;

      case WStype_DISCONNECTED:
            Serial.printf("[%u] Disconnected\n", num);
      break;


     case WStype_CONNECTED: {
            IPAddress ip = webSocket.remoteIP(num);
            Serial.printf("[%u] Connected from %d.%d.%d.%d url: %s\n", num, ip[0], ip[1], ip[2], ip[3], payload);
            // send message to client
            webSocket.sendTXT(num, "Setup Iniciado\n");
        }
      break;
    }
}


//------------------------------------------------------------------------------displayNumDiasSinAcc
void displayNumDiasSinAcc(uint16_t h, uint32_t col) // ARGUMENTOS: Número a mostrar, color para Wheel().
{
  uint16_t millares = h / 1000;
  uint16_t centenas = (h % 1000)/100;
  uint16_t decenas = ((h%1000)%100)/ 10;
  uint16_t unidades = ((h%1000)%100)%10;
  //int j = numPixAnio + numPixMes + numPixFechas; //Para la posicion del neopixel.
  int j = 0;  //Para la posicion del neopixel
  int i = 0;

  // -------------------------------------------- unidades
  for (i = 0; i < 7; i++)
  {
    if (numbers[unidades] & (1 << 7 - i))
    {
      strip1.setPixelColor(j ,NivelAccidente(col));
      strip1.setPixelColor(j+1 , NivelAccidente(col));
      strip1.setPixelColor(j+2 , NivelAccidente(col));
    }
    else
    {
      strip1.setPixelColor(j , 0,0,0);
      strip1.setPixelColor(j+1 , 0,0,0);
      strip1.setPixelColor(j+2 , 0,0,0);
    }
    j=j+3;
  }

  //-------------------------------------------- decenas
  j=0;
  for (i = 0; i < 7; i++)
  {
    if ((numbers[decenas] & (1 << 7 - i)) && ((decenas >= 1) || (centenas >= 1) || (millares >= 1))) //el cero no se muestra
    {
      strip1.setPixelColor(j + 21, NivelAccidente(col));
      strip1.setPixelColor(j+1 + 21,NivelAccidente(col));
      strip1.setPixelColor(j+2 + 21,NivelAccidente(col));
    }
    else
    {
      strip1.setPixelColor(j + 21, 0,0,0);
      strip1.setPixelColor(j+1 + 21, 0,0,0);
      strip1.setPixelColor(j+2 + 21, 0,0,0);
    }
   j=j+3;
 }

 // ---------------------------------------- centenas
  j=0;
  for (i = 0; i < 7; i++)
  {
    if ((numbers[centenas] & (1 << 7 - i)) && ((centenas >= 1) || (millares >= 1))) //el cero no se muestra
    {
      strip1.setPixelColor(j + (21*2),NivelAccidente(col));
      strip1.setPixelColor(j+1 + (21*2),NivelAccidente(col));
      strip1.setPixelColor(j+2 + (21*2),NivelAccidente(col));
    }
    else
    {
      strip1.setPixelColor(j + (21*2), 0,0,0);
      strip1.setPixelColor(j+1 + (21*2), 0,0,0);
      strip1.setPixelColor(j+2 + (21*2), 0,0,0);
    }
  j=j+3;
 }
 j=0;
 //---------------------------------------- millares
  for ( i = 0; i < 7; i++)
  {
    if ((numbers[millares] & (1 << 7 - i)) && (millares >= 1)) // Que sea diferente de cero
      { //Revisa el byte específico del vector y decide si debe encenderlo de algún color o apagarlo
        strip1.setPixelColor(j + (21 * 3), NivelAccidente(col)); //Le asigna el color o...
        strip1.setPixelColor(j+1 + (21 * 3), NivelAccidente(col));
        strip1.setPixelColor(j+2 + (21 * 3), NivelAccidente(col));
      }
    else
    {
      strip1.setPixelColor(j + (21 * 3 ), 0,0,0); //...lo apaga
      strip1.setPixelColor(j+1 + (21 * 3), 0,0,0);
      strip1.setPixelColor(j+2 + (21 * 3), 0,0,0);
    }
    j=j+3; //Posicion del Neopixel
  }
  strip1.show();
}

//############################################################3
//---------------------------------------------------------------------------- displayNumMes
void displayNumMes(uint16_t h, uint32_t col)
{
  uint16_t decenas = (h%100)/ 10;
  uint16_t unidades = (h%100)%10;

  //Serial.println(decenas);
  //Serial.println(unidades);
  //int j = numPixAnio + numPixMes + numPixFechas; //Para la posicion del neopixel.
  int j = 0;  //Para la posicion del neopixel
  int i = 0;

  //-------------------------------------------- unidades
  j=7;
  for (i = 1; i <= 7; i++)
  {
    if (numbersINV[unidades] & (1 << i))//el cero no se muestra
    {
      strip2.setPixelColor(j, NivelAccidente(col));
    }
    else
    {
      strip2.setPixelColor(j, 0,0,0);
    }
   j=j+1;
  }
  j=0;
  // -------------------------------------------- decenas
  for (i = 1; i <= 7; i++)
  {
    if ((numbersINV[decenas] & (1 << i))&& (decenas >= 1))
    {
      strip2.setPixelColor(j ,NivelAccidente(col));
    }
    else
    {
      strip2.setPixelColor(j , 0,0,0);
    }
    j=j+1;
  }
   strip2.show();
}

//#######################################################################


//------------------------------------------------------------------------------displayNumAnio
void displayNumAnio(uint16_t h, uint32_t col)
{
  uint16_t decenas = (h%100)/ 10;
  uint16_t unidades = (h%100)%10;
  //int j = numPixAnio + numPixMes + numPixFechas; //Para la posicion del neopixel.
  int j = 0;  //Para la posicion del neopixel
  int i = 0;

  // -------------------------------------------- unidades
  for (i = 0; i < 7; i++)
  {
    if (numbers[unidades] & (1 << 7 - i))
    {
      strip3.setPixelColor(j ,NivelAccidente(col));
    }
    else
    {
      strip3.setPixelColor(j , 0,0,0);
    }
    j=j+1;
  }

  //-------------------------------------------- decenas
  j=0;
  for (i = 0; i < 7; i++)
  {
    if ((numbers[decenas] & (1 << 7 - i)) && (decenas >= 1))//el cero no se muestra
    {
      strip3.setPixelColor(j + 7, NivelAccidente(col));
    }
    else
    {
      strip3.setPixelColor(j + 7, 0,0,0);
    }
   j=j+1;
 }
   strip3.show();
}


//------------------------------------------------------------------------------displayAccidente
// Esta función deberia mostrar los días sin accidentes en 4 displays de 7 segmentos
// Esta función se utiliza si es una sola tira que se une a la salida de la Cruz
void displayAccidente(uint16_t h, uint32_t col)
{
   uint16_t i;
   int omitir = segmDiaTotal[h-1];  //Accede al arreglo segmDiaTotal una posicion anterior a la seleccionada para saber cuantos npx omitir
   int mostrar = segmDia[h];        //Accede a este arreglo para saber el numero de leds a encender posteriormente en el ciclo for
   for (uint16_t i=0; i<mostrar; i++)
   {
    strip.setPixelColor(i+omitir, NivelAccidente(col));
   }
    strip.show();

}


//---------------------------------------------------------------------- apagaPixels
void apagaPixels()
{
    uint16_t i;
    for( i =  0; i < strip.numPixels(); i++) //
    {
      strip.setPixelColor(i,0,0,0);
      strip.show();
      //strip1.setPixelColor(i,0,0,0);
      //strip2.setPixelColor(i,0,0,0);
      //strip3.setPixelColor(i,0,0,0);


      //strip1.show();
      //strip2.show();
      //strip3.show();

      delay(1);
    }

}


//------------------------------------------------------------------------------NivelAccidente
// Segun el nivel de accidente se cambia el color, el 0 defualt es verde, sin accidente
uint32_t NivelAccidente(byte pos)
{
  switch (pos)
  {
    case 0:
      return strip.Color(0,64,16);  //Verde, ¡¡ SI EL COLOR VERDE SE MANDA A 255 SE ATENUAN LOS AZULES !!
      break;

    case 1:
      return strip.Color(128,32,0); //Naranja, hay problemas para mostrar el color naranja con los npx [naranja = ()]violeta = 193,0,255
      break;

    case 2:
      return strip.Color(0,0,255);  //Azul
      break;

    case 3:
      return strip.Color(64,64,0);//Amarillo255,195,0
      break;

    case 4:
      return strip.Color(128,0,0);  //Rojo
      break;

    case 5:
      return strip.Color(0,0,0);  //Apaga un numero
      break;
    }
}

//---------------------------------- Input a value 0 to 255 to get a color value r - g - b - back to r + a number (0-255) for brightness!!
uint32_t Wheel(byte WheelPos)
{


  if (WheelPos == 0)
  { //Para el color blanco
    return strip.Color(0, 0, 0,255);
    //return strip.Color(255, 255, 255);
  }
else {
  WheelPos = 255 - WheelPos;
  if (WheelPos < 85 && WheelPos >0 )
  {
    return strip.Color(255 - WheelPos * 3, 0, WheelPos * 3);
  }
  else if (WheelPos < 170)
  {
    WheelPos -= 85;
    return strip.Color(0, WheelPos * 3, 255 - WheelPos * 3);
  }
  else
  {
    WheelPos -= 170;
    return strip.Color(WheelPos * 3, 255 - WheelPos * 3, 0);
  }
}
}


/*void receiveEvent(size_t howMany)
{
  (void) howMany;
  while (1 < Wire.available())
  { // loop through all but the last
    char c = Wire.read(); // receive byte as a character
    Serial.print(c);         // print the character
  }
  int x = Wire.read();    // receive byte as an integer
  Serial.println(x);         // print the integer
}*/

// ######################################################################################
//----------------------------------------------------- configuraciones
void setup()
{
  // Se inicializa SPIFFS
  SPIFFS.begin();
  delay(1000);

  // Se inicializa el puerto serie
  Serial.begin(115200);

  // Se inicializa la comunicacion por I2C  (SDA,SCL,ADD)
  //Wire.begin(D6,D5,0x08);
  //Wire.onReceive(receiveEvent); // register event

  // Se inician los neopixels
  strip.setBrightness(Brightness);
  strip.begin();
  delay(100);
  apagaPixels();
  //strip.show();


  strip1.begin();
  delay(100);
  strip1.show();

  strip2.begin();
  delay(100);
  strip2.show();

  strip3.begin();
  delay(100);
  strip3.show();

  Serial.print("\nSetting up WiFi... ");
  setupWiFi();
  delay(1000);//wait for a second

  if(MDNS.begin("esp8266"))  // MDNS permite "encontrar" al ESP por nombre e IP
  {
    Serial.println("\nMDNS responder started");
  }


  // handle index
  server.on("/",handleIndexFile);

  server.on("/list", handleFileList);
// Servidor para actualizar los archivos para la pagina web
  server.on("/web", HTTP_POST, [](){
  server.send(200, "text/plain", "{\"success\":1}");
}, handleFileUpload);

  // Servidor para actualizar el programa vía WEB
  httpUpdater.setup(&server);

  server.begin();
  webSocket.begin();
  webSocket.onEvent(webSocketEvent);

  // Add service to MDNS
  MDNS.addService("http", "tcp", 80);
  MDNS.addService("ws", "tcp", 81);
  //webSocket.broadcastTXT("Display Cruz de Seguridad Industria 4.0\n");


  Serial.println("Iniciado");
}

//--------------------------------------------------- loop
void loop()
{
  webSocket.loop();
  server.handleClient();

  if (Serial.available()>0)
  { //Para checar el puerto serial
    //char c[] = {(char)Serial.read()};  Para esperar datos por el puerto serie y enviar por websoket
    //webSocket.broadcastTXT(c, sizeof(c));

    tecla = Serial.read();  //Lee el primer caracter de la cadena
    switch (tecla)
    {
      case 'n':   //numero de días
        //delay(1000);
        //Serial.println("Ingrese Dia del Mes y nivel de Accidente (0,1,2,3,4): ");
        dia = Serial.readStringUntil(',');
        fechaAccidente = dia.toInt();
        valColor = Serial.readStringUntil(')');
        color = valColor.toInt();
        if((color <= 5) && ((fechaAccidente > 0) && (fechaAccidente <= 31)))  // El argumento de nivel de acciodente (color) no tiene opciones mayores a 5
        {
          Serial.print("Fecha: ");
          Serial.print(fechaAccidente);
          Serial.print("\t");
          Serial.print("Color: ");
          Serial.println(color);
          displayAccidente(fechaAccidente,color);
        }
        else
        {
          Serial.println("Nivel o día de accidente incorrecto");
        }
      break;

      case 't':   //Total
        valDiaActual = Serial.readStringUntil(','); ndiaact = valDiaActual.toInt();
        valColor = Serial.readStringUntil(')'); color1 = valColor.toInt();

        if((ndiaact >= 0) && (ndiaact <= 9999))  // El argumento de nivel de acciodente (color) no tiene opciones mayores a 5
        {
          displayNumDiasSinAcc(ndiaact,color1);

          Serial.print("Dias: ");
          Serial.print(valDiaActual);
          Serial.print("\t");
          Serial.print("Color: ");
          Serial.println(valColor);
        }
        else
        {
          Serial.println("Valor de dias fuera de rango");
        }
      break;

      case 'm':   //Mes
        valMes = Serial.readStringUntil(','); mes = valMes.toInt();
        valColor = Serial.readStringUntil(')'); color1 = valColor.toInt();
        if((mes > 0) && (mes<=12))
        {
          displayNumMes(mes,color1);
          Serial.print("Mes: ");
          Serial.print(mes);
          Serial.print("\t");
          Serial.print("Color: ");
          Serial.println(color1);
        }
        else
        {
          Serial.println("Valor de mes fuera de rango");
        }
      break;

      case 'y':   //Año
        valAnio = Serial.readStringUntil(','); anio = valAnio.toInt();
        valColor = Serial.readStringUntil(')'); color1 = valColor.toInt();
        if((anio >= 0) && (anio <=99))
        {
          displayNumAnio(anio,color1);
          Serial.print("Anio: ");
          Serial.print(anio);
          Serial.print("\t");
          Serial.print("Color: ");
          Serial.println(color1);
        }
        else
        {
          Serial.println("Valor de anio fuera de rango");
        }
      break;

      case 'c':   //clear
        //delay(1000);
        Serial.println("Apagando display");
        apagaPixels();
      break;
    }

  }

}
