Cardansan/Cruz-De-Seguridad/(commit log)

2019-05-18 Se sube el primer archivo de flujos.
2019-05-18 Suben diseños de display 4 dígitos
    [4 Dígitos BOTTOM.DXF, 4 Dígitos BOTTOM.SLDDRW, 4 Dígitos CABLE.DWG, 4 Dígitos CABLE.DXF, 4 Dígitos CABLE.SLDDRW, 4 Dígitos TOP.DWG, 4 Dígitos TOP.DXF, 4 Dígitos TOP.SLDDRW]
2019-05-18 Reubicacion DXFs
    [4 Dígitos BOTTOM.DXF, 4 Dígitos CABLE.DWG, 4 Dígitos CABLE.DXF, 4 Dígitos TOP.DXF, Display BOTTOM.DXF, Display CABLE.DXF, Display TOP.DXF]
2019-05-18 Copia de flujos desde tarjeta SD
2019-05-28 Eliminación de duplicados
2019-06-04 Add files via upload
    PCB con errores corregidos.
    Sólo falta añadir el conector a usar en la entrada*
    [pcb segmentos_digitos.pdsprj]
2019-06-04 Add files via upload
    Suprimir los 3 displays grandes
    [pcb segmentos digitos correctos.pdsprj]
2019-06-06 Create Ensamble cruz de seguridad
    Los archivos están guardados en .SLDPRT 2018 y como parasolid (.x_t) para que se puedan abrir en Fusion 360 o una versión pasada de Solidworks. Ya hice la prueba de esto.
    Son todos los diseños, 3 niveles por grupo, recordemos que son 3 grupos.
    Para cargar el PCB en el ensamble sugiero abrir PCB.WinRaR ahí vienen todos los componentes del ensamble del PCB. Si no carga por las versiones, importar el CAD PCB.STEP que viene dentro del RaR y agregarlo al ensamble.
    Agregué el tablero de la cruz gigante junto con su parasolid.
    Y desde luego el ensamble, guardé el mismo ensamble en formatos distintos: como archivo ensamble 2018 (.SLDASM), binario (.x_t) y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
2019-06-06 Add files via upload
    Adjunto los archivos del ensamble de la cruz. Guardé todos en formato solid 2018 (.SLDPRT), así como en parasolid (.x_t) para que lo puedan abrir en versiones pasadas de solidworks y en fusion.
    Son:
    3 grupos con sus respectivas 3 capas.
    Cruz original el cual es el tablero principal.
    PCB, éste tiene el detalle que es un ensamble complejo, sus componentes están en PCB.rar si no llegara a cargar en el ensamble, también lo guardé en .STEP para abrirlo en cualquier software de diseño pero la desventaja es que se tiene que guardar como pieza y volver a ensamblarlo en "Ensamble de cruz de seguridad".
    Descargué el CAD del tornillo a utilizar, es un M3 x.5x20 obteni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
    [CAD PCB.SLDASM, Cruz capa 1.SLDPRT, Cruz capa 1.x_t, Cruz capa 2.SLDPRT, Cruz capa 2.x_t, Cruz capa 3.SLDPRT, Cruz capa 3.x_t, Ensamble cruz de seguridad.SLDASM]
2019-06-17 Placas separadas
    [1-3.pdsprj, 10-11.pdsprj, 12-13.pdsprj, 14-16.pdsprj, 17-18.pdsprj, 19-20.pdsprj, 21-23.pdsprj, 24-25.pdsprj]
2019-06-21 Add files via upload
    DxFs correctos, los que dicen barrenos o cortes son los que se mandarán a cortar
    [Cruz Digital Original barrenos 3.DXF, Cruz capa 1.DXF, Cruz capa 2 corte barrenos.DXF, Cruz capa 2.DXF, Cruz capa 3.DXF, Grupo 2 capa 1.DXF, Grupo 2 capa 2 corte.DXF, Grupo 2 capa 3.DXF]
2019-08-13 Seleccion de dia total, mes, año
2019-08-15 diagrama cruz de seguridad
2019-08-15 se modificó funcion displayAccidente y tuvo errores al mostrar dias en cruz
    [Display_Cruz_de_Seguridad.ino]
2019-08-15 Revert "Se eliminaron comentarios y lineas no necesarios"
    This reverts commit 025126d4075a6d2b00cee23bf482e248f3ba2f30.
    [Display_Cruz_de_Seguridad.ino]
2019-08-16 Tornillos de cabeza avellanada con hueco hexagonal
    Tornillos para las placas PRY397 y ensamble total de la cruz
    [Body_1.sldprt, Body_1_2.sldprt, Body_1_3.sldprt, CAD PCB I.SLDASM, CAD PCB.STEP, CAD PCB.x_t, Cruz capa 1.x_t, Cruz capa 2.x_t]
2019-08-16 Seleccion de fecha, dias totales, mes, año y seleccion de color. Arduino se desconecta cada cierto tiempo
2019-08-16 se elimino flow duplicado
2019-08-17 Modificaciones de la capa cruz y cruz original
2019-08-19 Cambio de pines de salida para ESP8266 y modificacion de archivo .ini
2019-08-19 Se agregò codigo Wemos a Cruz de seguridad
2019-08-19 Se combina codigo cruz de seguridad con mainESP8266
2019-08-20 Creacion de funcion para obtener IP
2019-08-20 Se regresa a pines anteriores de ESP8266
2019-08-21 Se agrego diseño de shild para raspberry
    [Escudo_cruz.brd, Escudo_cruz.sch]
2019-08-21 Fotofrafias_Cruz-seguridad
    Procedimiento para el montaje
2019-08-21 Fotografias_Cruz-seguridad
    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
2019-08-22 Revisión de unión de programa de página web + puente
    Se movieron las funciones de setup y loop al final del código. Se comentó la parte que transmite del puerto serie a la página web porque aún tiene conflictos, también hay un problema cuando se cambia de color algunas veces no cambia el color solo le baja la intensidad, pasó de sin accidente a casi accidente
    [Display_Cruz_de_Seguridad.ino]
2019-08-23 Correcciones de color e ingreso de la información
    Se resolvió la inicialización más limpia de los datos, los colores son más estables y más definidos, se restringe los datos de fechas y tipo de accidente fuera de rango
2019-08-24 Interfaz de AP con websoket funcionando
    Se separó la página web del resto de código, enviandola a un archivo index.html en una carpeta data, se almacena por SPIFFS, los archivos para spiffs se actualizan en el ESP con el comando en terminal: platformio run --target uploadfs, para continuar con la actualización de los archivos
2019-08-28 Diagrama de conexión
    Shield y Displays de la cruz de seguridad
2019-08-29 Se agregan archivos de ensamble
    archivos utilizados para el ensamble de cruz de seguridad
    [Cruz capa 2.f3d, Cruz capa 3.f3d, DIN_EN_ISO_10642_M3x20.f3d, DIN_EN_ISO_10642_M3x25.f3d, DIN_EN_ISO_10642_M3x8.f3d, Fuente 5V.f3d, Grupo 2 capa 1.f3d, Grupo 2 capa 2.f3d]
2019-08-29 Se agregan tuercas a tornillos
    [DIN_EN_ISO_10642_M3x20.f3z, DIN_EN_ISO_10642_M3x25.f3z, DIN_EN_ISO_10642_M3x8.f3z]
2019-08-29 Se agregan capas de cruz, tapas
    [Cruz capa 1 con tornillos.f3z, Grupo 2 capa 3.f3d, Grupo 3 capa 3.f3d, M8x20.f3d, M8x20.f3z]
2019-08-30 Se añaden orificios a la fuente de 5V para su ensamble y caja
    [Caja.f3d, Caja_Tapa.f3d, Fuente 5V.f3d]
2019-08-30 Se agrega ESP para comunicarse mediante I2C con Raspberry
    [Escudo_cruz.brd, Escudo_cruz.sch]
2019-08-30 Correcciones de dimensiones
    [79914_2.5x6.f3d, Caja_Base.f3d, Ensamble Caja con Fuente.f3z]
2019-08-30 actualizacion en ensamble (se agrega caja y fuente de 5v)
    [DIN_EN_ISO_10642_M3x8_Fuente.f3z]
2019-09-02 correccion en dimensiones de ensamble
    [Ensamble Caja con Fuente.f3z]
2019-09-02 Se añaden orificios para pines en capas displays dias totales, mes y año
    [Caja_Base.f3d, Caja_Tapa.f3d, Ensamble Caja con Fuente.f3z, Grupo 2 capa 1.f3d, Grupo 3 capa 1.f3d]
2019-09-02 DXF de capas para mes y año
    [Mes_Año_Capa1.dxf, Mes_Año_Capa2.dxf, Mes_Año_Capa3.dxf]
2019-09-03 Se añaden PCB a capa de mes y año, y se movió posición de la fuente de 5v en caja
    [Caja_Base.f3d, Caja_Tapa.f3d, Ensamble Caja con Fuente.f3z, Grupo 3 capa 1.f3z]
2019-09-04 Internet SIM+Raspberry
    Archivos de configuracion para hacer coneccion ppp
2019-09-04 Cambios
    Cortes de las capas 1-3 del grupo 2 y capas1 y 3 del grupo 3. Ademas de modificar la capa original para el grupo 2.
    [Escudo_cruz.brd, Escudo_cruz.sch, Grupo 2 capa 1.f3z, Grupo 2 capa 2.f3d, Grupo 2 capa 3.f3d, Grupo 3 capa 1.f3z, Grupo 3 capa 3.f3d, PRY397.brd]
2019-09-06 Se agregaron restricciones a los comandos serie
    En días sin accidentes se agregó la restricción entre 0 y 9999, y en mes de 1 a 12
2019-09-06 Corrección en display de días
    Se cambiaron nomenclaturas para reorganizar el orden de los LEDs y Displays en función de colocar las unidades al inicio de la tira e ir creciendo según los leds por segmento y la cantidad de dígitos a mostrar
2019-09-06 Reorganización de display días y año
    Se arregló el orden de los display en función de seguir la lógica de empezar por unidades y hacer la trayectoria de los leds en S, se cambión en la función para enviar el blanco directamente ya que esos display usan RGBW, falta resolver el orden del display del mes ya que está invertido y con otra configuracion de la tira
    [Display_Cruz_de_Seguridad.ino]
2019-09-07 Correccion Display MES
    Se hizo una funcion especial pjunto con su arreglo para resolver que el display se encuentra invertido y la entrada está en las decenas, se resolvió que los números no se pasen de sus límites lógicos de mes y año y un detalle que tenía días que dejaba una sombra en el último dígito
    [Display_Cruz_de_Seguridad.ino]
2019-09-07 Orden y reordenamiento de los flujos,
2019-09-09 Cortes Mes y Año
    Grupo tres capa 1 y 3
    [Escudo_cruz.brd, Escudo_cruz.sch, Grupo 2 capa 1.f3z, Grupo 3 capa 1.f3z, Grupo 3 capa 3.f3d]
2019-09-10 Se agregó el protocolo I2C
    Para sustituir la comunicación por puerto serie en los módulos
2019-09-10 Se agregó OTA por WEB
    Ahora se puede actualizar el archivo binario del código inalambricamente al accecer a la ip, http://192.168.4.1/update
2019-09-10 Se actualizó OTA para el firmware y la pagina WEB
    Ahora se pueden enviar también archivos estando en la red wifi con el siguiente método por la terminal
    curl -F "file=@$PWD/index.html" 192.168.4.1/web
    y con eso se actualiza el archivo de la pagina web tambien por OTA
2019-09-11 Se eliminó I2C, se ajustaron colores por nivel de accidente
    El ESP no funciona normalmente como esclavo de i2c, para hacerlo funcionar es necesario modificar varias librerias.
    Se ajusto para que el color de los display de días, mes y año coincidieran con el color según el nivel de accidente, debido a que estos se mostraran segun el nivel de accidente del día actual.
    Se cambio "," por ")" para la comunicación serie
2019-09-11 Modificaciones SHIELD raspberry
    Se descarta la idea de la comunicación I2C y se agrega una quinta salida de display para indicar la tonalidad del tipo de accidente.
    Cambios a los cortes del grupo 2 capas 1, 2 y 3
    [Escudo_cruz.brd, Escudo_cruz.sch, Grupo 2 capa 1.f3z, Grupo 2 capa 2.f3d, Grupo 2 capa 3.f3d]
2019-09-12 Se reconfiguraron las ventanas del dashboard, se utiliza la librería de 'moment' en las funciones de los nodos
2019-09-12 Ajuste de letras para comando serie
    Se cambiaron los comandos por puerto serie porque se generan comandos basura que los estaba activando quedando ahora
    n - para ingresar fecha en la cruz
    t - total de días sin accidente
    m - mes actual
    y - año actual
    c - limpiar cruz
2019-09-12 Se ajustaron los comandos por puerto serie para evitar reacciones por letras basura
    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
2019-09-13 Se envían ya los días sin accidente con un contero automático, aún se debe corregir el cambio de hora y fecha para sistema y tambien hacer que funcione la hora de cambio, ya se dibuja el mes y año
2019-09-13 Manda un arreglo con los días y el nivel de accidente al panel
2019-09-14 Se actualiza la fecha desde el panel principal y se guarda en global
2019-09-14 Se agregó la función de cambiar el color de los días, el mes y el año en función del nivel de accidente del día actual
2019-09-16 El accidente incapacitante puede reiniciar la cuenta en automàtico cuando se modifica en ajustes, reinicia la cuenta si es el día actual, o la actualiza según la cantidad de días
2019-09-16 Se modificó un poco la interfaz, se cambió de orden, aún no se resuelve el cambio de hora desde el hardware, al parecer el cambio no es permanente, pero se mantiene probablemnte de internet
2019-09-20 Ya funciona ajuste de hora
2019-10-02 se descomentó el APN para selecionar Telcel
2019-10-04 Placas adicionales para la cruz digital
    Placas P1 Y P2345 alimentación para los displays.
    [P1.brd, P1.sch, P2345.brd, P2345.sch]
